davidjperez00/alarm-system/hardware/alarm_system_hardware/manufacturing/V0.02/bom-JLCPCB Assembly Order.xls

JLCPCB BOM Tool - BOM Matching
BOM name：bom-JLCPCB Assembly Order.xlsx |  |  | Download Time：2026-09-25 21:37:16 |  |  |  | * Our matching results are updated in real-time, but stock and prices may change. If it's been over 24 hours, please re-match before placing your order.
PCB Assembled Qty：5 |  |  | Est. Total Price：55.9497
Your BOM |  |  |  | Matched Parts |  |  |  |  |  |  | Order Information
Designator | Comment | Footprint | JLCPCB Part # | Matches | Part # | Manufacturer | Footprint | Description | Category | Warning | JLCPCB Part # | Product link | Lib Type | Qty | Source | Total Price ($)
BZ1 | Buzzer | PS1440P02BT_TDK |  | Select by Customer | PS1440P02BT | TDK | 插件,D=14mm | -10℃~+70℃ 14mm 30V 3V 4kHz 5mm 75dB 9.2mm Passive (Externally Driven) Piezoelectric Through-hole 插件,D=14mm Buzzers ROHS | Buzzers |  | C96060 | https://jlcpcb.com/partdetail/TDK-PS1440P02BT/C96060 | Extended | 2 | 2 JLCPCB | 0.8342
C1,C16,C17,C18,C22,C6,C8 | 0.1uF | 0805 |  | Unconfirmed | CC0805KRX7R9BB104 | YAGEO | 0805 | 100nF 50V X7R ±10% 0805 Multilayer Ceramic Capacitors MLCC - SMD/SMT ROHS | Multilayer Ceramic Capacitors MLCC - SMD/SMT | 1.The comment (CC0805KRX7R9BB104) of this part does not match the one (0.1uF) provided in your BOM. Please confirm; | C49678 | https://jlcpcb.com/partdetail/YAGEO-CC0805KRX7R9BB104/C49678 | Basic | 24 | 24 JLCPCB | 0.4584
C10,C2,C23,C3,C4,C5 | 1uF | 0805 |  | Select by System | CL21B105KBFNNNE | Samsung Electro-Mechanics | 0805 | 1uF 50V X7R ±10% 0805 Multilayer Ceramic Capacitors MLCC - SMD/SMT ROHS | Multilayer Ceramic Capacitors MLCC - SMD/SMT |  | C28323 | https://jlcpcb.com/partdetail/29074-CL21B105KBFNNNE/C28323 | Basic | 22 | 22 JLCPCB | 0.8756
C11,C12,C15,C24,C7,C9 | 10uF | 0805 |  | Select by System | CL21A106KAYNNNE | Samsung Electro-Mechanics | 0805 | 10uF 25V X5R ±10% 0805 Multilayer Ceramic Capacitors MLCC - SMD/SMT ROHS | Multilayer Ceramic Capacitors MLCC - SMD/SMT |  | C15850 | https://jlcpcb.com/partdetail/16532-CL21A106KAYNNNE/C15850 | Basic | 22 | 22 JLCPCB | 1.7336
C13 | 47nF | 0805 |  | Select by System | CL21B473KBCNNNC | Samsung Electro-Mechanics | 0805 | 47nF 50V X7R ±10% 0805 Multilayer Ceramic Capacitors MLCC - SMD/SMT ROHS | Multilayer Ceramic Capacitors MLCC - SMD/SMT |  | C53134 | https://jlcpcb.com/partdetail/54150-CL21B473KBCNNNC/C53134 | Basic | 20 | 20 JLCPCB | 0.346
C14 | 4.7uF | 0805 |  | Select by System | CL21A475KAQNNNE | Samsung Electro-Mechanics | 0805 | 25V 4.7uF X5R ±10% 0805 Multilayer Ceramic Capacitors MLCC - SMD/SMT ROHS | Multilayer Ceramic Capacitors MLCC - SMD/SMT |  | C1779 | https://jlcpcb.com/partdetail/2131-CL21A475KAQNNNE/C1779 | Basic | 20 | 20 JLCPCB | 0.69
C19,C21 | 22uF | 0805 |  | Select by System | CL21A226MAQNNNE | Samsung Electro-Mechanics | 0805 | 22uF 25V X5R ±20% 0805 Multilayer Ceramic Capacitors MLCC - SMD/SMT ROHS | Multilayer Ceramic Capacitors MLCC - SMD/SMT |  | C45783 | https://jlcpcb.com/partdetail/46786-CL21A226MAQNNNE/C45783 | Basic | 4 | 4 JLCPCB | 0.8796
D1,D11,D15,D2,D3,D4,D5,D6,D7,D8 | GREENLED | 0805 |  | Unconfirmed | KT-0805G | Hubei KENTO Elec | 0805 | -40℃~+85℃ 100mW 120° 2.6V~3.1V 430mcd 513nm~528nm 525nm 5mA Discrete Diode Emerald Green Water Clear 0805 LED Indication - Discrete ROHS | LED Indication - Discrete | 1.The comment (KT-0805G) of this part does not match the one (GREENLED) provided in your BOM. Please confirm; | C2297 | https://jlcpcb.com/partdetail/Hubei_KENTOElec-KT0805G/C2297 | Basic | 30 | 30 JLCPCB | 0.489
D9 | TSD05DYFR | D_SOD-323_HandSoldering |  | Select by System | TSD05DYFR | Texas Instruments | SOD-323 | -55℃~+150℃ 15V 19pF 5.5V 50nA 529W@8/20us 60A@8/20us 6V IEC 61000-4-2、IEC 61000-4-5 TVS SOD-323 ESD and Surge Protection (TVS/ESD) ROHS | ESD And Surge Protection (TVS/ESD) |  | C22396185 | https://jlcpcb.com/partdetail/TexasInstruments-TSD05DYFR/C22396185 | Extended | 6 | 6 JLCPCB | 1.4022
D10,D12,D13 | REDLED | 0805 |  | Select by Customer | LTST-C171KRKT | Lite-On | 0805 | -55℃~+85℃ 130° 20mA 2V 54mcd 631nm 639nm 75mW Discrete Diode Red Water Clear 0805 LED Indication - Discrete ROHS | LED Indication - Discrete |  | C284871 | https://jlcpcb.com/partdetail/LiteOn-LTSTC171KRKT/C284871 | Extended | 20 | 20 JLCPCB | 0.524
F1 | Fuse | 0805 |  | Select by Customer | MFU0805FF03000P500 | Vishay Intertech | 0805 | -55℃~+125℃ 0.023 0.45mm 1.25mm 2mm 32V 3A 50A Surface Mount Fuse 0805 Disposable fuses ROHS | Disposable Fuses |  | C3162437 | https://jlcpcb.com/partdetail/VishayIntertech-MFU0805FF03000P500/C3162437 | Extended | 2 | 2 JLCPCB | 1.0816
FB1 | BBUP00321611121Y00 | 1206 |  | Select by System | BBUP00321611121Y00 | Chilisin Elec | 1206 | -55℃~+125℃ 1 120Ω@100MHz 12mΩ 6A ±25% 1206 Ferrite Beads ROHS | Ferrite Beads |  | C6751041 | https://jlcpcb.com/partdetail/ChilisinElec-BBUP00321611121Y00/C6751041 | Extended | 15 | 15 JLCPCB | 1.0365
IC1 | PCA9955BTWJ | SOP65P640X110-29N |  | Select by System | PCA9955BTWJ | NXP Semicon | HTSSOP-28-EP | -40℃~+105℃ 16 31.25kHz~1MHz 3V~5.5V 4% 57mA DC-DC Over-Temperature Protection (OTP)、Short-Circuit Protection PWM、I2C HTSSOP-28-EP LED Drivers ROHS | LED Drivers |  | C2678563 | https://jlcpcb.com/partdetail/NXPSemicon-PCA9955BTWJ/C2678563 | Extended | 2 | 2 JLCPCB | 5.7846
J2 | USB_C_Receptacle_USB2.0_16P | SAMESKY_UJ20-C-H-G-SMT-1-P16-TR |  | Select by Customer | UJ20-C-H-G-SMT-1-P16-TR | CUI | SMD | -25℃~+85℃ 1 10,000 cycles 16P 20V 5A Female Surface Mount, Right Angle Type-C USB 2.0 SMD USB Connectors ROHS |  |  | C45082766 | https://jlcpcb.com/partdetail/CUI-UJ20_C_H_G_SMT_1_P16TR/C45082766 | Extended | 2 | 2 JLCPCB | 1.5006
J4 | Conn_01x02_Socket | CONN_S2B-PH-K-S_JST |  | Select by Customer | S2B-PH-K-S-GW | JST | 弯插,P=2mm | -25℃~+85℃ 1 100V 1x2P 2 2A 2P 2mm 4.8mm 5.9mm 7.6mm Brass K Pin PA66 PH Right Angle Tin UL94V-0 White 弯插,P=2mm Wire To Board Connector ROHS | Wire To Board Connector |  | C157932 | https://jlcpcb.com/partdetail/JST-S2B_PH_K_SGW/C157932 | Extended | 2 | 2 JLCPCB | 0.4406
J5 | MSD-11-A | CUI_MSD-11-A |  | Select by System | MSD-11-A | CUI | SMD | -40℃~+85℃ 1.85mm 30V Connector and Ejector MicroSD Card (TF Card) Push-Pull With Locating Pins SMD SD Card / Memory Card Connector ROHS | Global Sourcing Parts |  | C22467016 | https://jlcpcb.com/partdetail/CUI-MSD_11A/C22467016 | Extended | 2 | 2 JLCPCB | 1.741
J7 | Conn_01x03_Socket | TerminalBlock_Phoenix_PT-1,5-3-5.0-H_1x03_P5.00mm_Horizontal |  | Select by Customer | 1935174 | Phoenix Contact | 插件,P=5mm | 1 12~26 18A 1x3P 3 300V 3P 5mm Green Through Hole 插件,P=5mm Screw Terminal Blocks ROHS | Screw Terminal Blocks |  | C3816891 | https://jlcpcb.com/partdetail/PhoenixContact-1935174/C3816891 | Extended | 2 | 2 JLCPCB | 1.9716
L1 | 1uH | IND_VLS5045EX-1R0N |  | Select by Customer | VLS5045EX-1R0N | TDK | SMD,5x5mm | 15mΩ 1uH 5.1A 8.9A ±30% SMD,5x5mm Power Inductors ROHS | Power Inductors |  | C404484 | https://jlcpcb.com/partdetail/TDK-VLS5045EX1R0N/C404484 | Extended | 5 | 5 JLCPCB | 0.6775
L2 | 0.47uH | IND_IHLP-2020CZ-L |  | Select by Customer | FAUL0530-R47MT | cjiang (Changjiang Microelectronics Tech) | SMD,5.4x5.2mm | 11A 15A 470nH 8.5mΩ ±20% SMD,5.4x5.2mm Molding Power Inductors ROHS | Power Inductors | 1.The comment (FAUL0530-R47MT) of this part does not match the one (0.47uH) provided in your BOM. Please confirm; | C5298158 | https://jlcpcb.com/partdetail/6046328-FAUL0530R47MT/C5298158 | Extended | 5 | 5 JLCPCB | 1.5355
Q1 | AO3400A | SOT-23-3 |  | Select by System | AO3400A | Alpha & Omega Semicon | SOT-23 | -55℃~+150℃ 1 N-channel 1.45V 1.4W 30V 48mΩ@2.5V 5.7A 50pF 630pF 75pF 7nC@10V N-Channel SOT-23 MOSFETs ROHS | MOSFETs |  | C20917 | https://jlcpcb.com/partdetail/Alpha_OmegaSemicon-AO3400A/C20917 | Basic | 6 | 6 JLCPCB | 0.507
R1,R18,R19,R2,R24,R3,R30 | 10k | 0805 |  | Unconfirmed | 0805W8F1002T5E | UNI-ROYAL(Uniroyal Elec) | 0805 | -55℃~+155℃ 10kΩ 125mW 150V Thick Film Resistor ±1% ±100ppm/℃ 0805 Chip Resistor - Surface Mount ROHS | Chip Resistor - Surface Mount | 1.The comment (0805W8F1002T5E) of this part does not match the one (10k) provided in your BOM. Please confirm; | C17414 | https://jlcpcb.com/partdetail/18102-0805W8F1002T5E/C17414 | Basic | 24 | 24 JLCPCB | 0.0936
R10,R13,R53,R7,R8,R9 | 330 | 0805 |  | Unconfirmed | 0805W8F3300T5E | UNI-ROYAL(Uniroyal Elec) | 0805 | -55℃~+155℃ 125mW 150V 330Ω Thick Film Resistor ±1% ±100ppm/℃ 0805 Chip Resistor - Surface Mount ROHS | Chip Resistor - Surface Mount | 1.The comment (0805W8F3300T5E) of this part does not match the one (330) provided in your BOM. Please confirm; | C17630 | https://jlcpcb.com/partdetail/18318-0805W8F3300T5E/C17630 | Basic | 22 | 22 JLCPCB | 0.1078
R11 | 47k | 0805 |  | Unconfirmed | 0805W8F4702T5E | UNI-ROYAL(Uniroyal Elec) | 0805 | -55℃~+155℃ 125mW 150V 47kΩ Thick Film Resistor ±1% ±100ppm/℃ 0805 Chip Resistor - Surface Mount ROHS | Chip Resistor - Surface Mount | 1.The comment (0805W8F4702T5E) of this part does not match the one (47k) provided in your BOM. Please confirm; | C17713 | https://jlcpcb.com/partdetail/18401-0805W8F4702T5E/C17713 | Basic | 20 | 20 JLCPCB | 0.134
R12,R4,R5,R6 | 8.25k | 0805 |  | Unconfirmed | 1RC0805F8251 | SAE | 0805 | 0805 Chip Resistor - Surface Mount ROHS |  | 1.The comment (1RC0805F8251) of this part does not match the one (8.25k) provided in your BOM. Please confirm; | C54532369 | https://jlcpcb.com/partdetail/SAE-1RC0805F8251/C54532369 | Extended | 20 | 20 JLCPCB | 0.07
R14,R15,R27,R28,R29,R32,R54 | 100k | 0805 |  | Unconfirmed | 0805W8F1003T5E | UNI-ROYAL(Uniroyal Elec) | 0805 | -55℃~+155℃ 100kΩ 125mW 150V Thick Film Resistor ±1% ±100ppm/℃ 0805 Chip Resistor - Surface Mount ROHS | Chip Resistor - Surface Mount | 1.The comment (0805W8F1003T5E) of this part does not match the one (100k) provided in your BOM. Please confirm; | C149504 | https://jlcpcb.com/partdetail/160838-0805W8F1003T5E/C149504 | Basic | 24 | 24 JLCPCB | 0.1416
R16,R17,R35,R39,R43,R51,R52 | 0 | 0805 |  | Unconfirmed | 0805W8F0000T5E | UNI-ROYAL(Uniroyal Elec) | 0805 | -55℃~+155℃ 0Ω 125mW 150V Thick Film Resistor ±1% ±800ppm/℃ 0805 Chip Resistor - Surface Mount ROHS | Chip Resistor - Surface Mount | 1.The comment (0805W8F0000T5E) of this part does not match the one (0) provided in your BOM. Please confirm; | C17477 | https://jlcpcb.com/partdetail/18165-0805W8F0000T5E/C17477 | Basic | 24 | 24 JLCPCB | 0.1056
R20 | 2k | 0805 |  | Unconfirmed | 0805W8F2001T5E | UNI-ROYAL(Uniroyal Elec) | 0805 | -55℃~+155℃ 125mW 150V 2kΩ Thick Film Resistor ±1% ±100ppm/℃ 0805 Chip Resistor - Surface Mount ROHS | Chip Resistor - Surface Mount | 1.The comment (0805W8F2001T5E) of this part does not match the one (2k) provided in your BOM. Please confirm; | C17604 | https://jlcpcb.com/partdetail/18292-0805W8F2001T5E/C17604 | Basic | 20 | 20 JLCPCB | 0.078
R21,R23 | 4.7k | 0805 |  | Unconfirmed | 0805W8F4701T5E | UNI-ROYAL(Uniroyal Elec) | 0805 | -55℃~+155℃ 125mW 150V 4.7kΩ Thick Film Resistor ±1% ±100ppm/℃ 0805 Chip Resistor - Surface Mount ROHS | Chip Resistor - Surface Mount | 1.The comment (0805W8F4701T5E) of this part does not match the one (4.7k) provided in your BOM. Please confirm; | C17673 | https://jlcpcb.com/partdetail/18361-0805W8F4701T5E/C17673 | Basic | 20 | 20 JLCPCB | 0.1
R25 | 909k | 0805 |  | Unconfirmed | 1RC0805F9093 | SAE | 0805 | 0805 Chip Resistor - Surface Mount ROHS |  | 1.The comment (1RC0805F9093) of this part does not match the one (909k) provided in your BOM. Please confirm; | C54532387 | https://jlcpcb.com/partdetail/SAE-1RC0805F9093/C54532387 | Extended | 20 | 20 JLCPCB | 0.066
R31,R33,R45 | 200 | 0805 |  | Unconfirmed | 0805W8F2000T5E | UNI-ROYAL(Uniroyal Elec) | 0805 | -55℃~+155℃ 125mW 150V 200Ω Thick Film Resistor ±1% ±100ppm/℃ 0805 Chip Resistor - Surface Mount ROHS | Chip Resistor - Surface Mount | 1.The comment (0805W8F2000T5E) of this part does not match the one (200) provided in your BOM. Please confirm; | C17540 | https://jlcpcb.com/partdetail/18228-0805W8F2000T5E/C17540 | Basic | 20 | 20 JLCPCB | 0.134
R36 | 432 | 0805 |  | Unconfirmed | 0805W8F4301T5E | UNI-ROYAL(Uniroyal Elec) | 0805 | -55℃~+155℃ 125mW 150V 4.3kΩ Thick Film Resistor ±1% ±100ppm/℃ 0805 Chip Resistor - Surface Mount ROHS | Chip Resistor - Surface Mount | 1.The comment (0805W8F4301T5E) of this part does not match the one (432) provided in your BOM. Please confirm; | C17667 | https://jlcpcb.com/partdetail/18355-0805W8F4301T5E/C17667 | Extended | 20 | 20 JLCPCB | 0.158
R37 | 5.36k | 0805 |  | Unconfirmed | FRC0805F5361TS | FOJAN | 0805 | -55℃~+155℃ 125mW 150V 5.36kΩ Thick Film Resistor ±1% ±100ppm/℃ 0805 Chip Resistor - Surface Mount ROHS | Chip Resistor - Surface Mount | 1.The comment (FRC0805F5361TS) of this part does not match the one (5.36k) provided in your BOM. Please confirm; | C2999602 | https://jlcpcb.com/partdetail/FOJAN-FRC0805F5361TS/C2999602 | Extended | 20 | 20 JLCPCB | 0.064
R38 | 31.6k | 0805 |  | Unconfirmed | 0805W8F3162T5E | UNI-ROYAL(Uniroyal Elec) | 0805 | -55℃~+155℃ 125mW 150V 31.6kΩ Thick Film Resistor ±1% ±100ppm/℃ 0805 Chip Resistor - Surface Mount ROHS | Chip Resistor - Surface Mount | 1.The comment (0805W8F3162T5E) of this part does not match the one (31.6k) provided in your BOM. Please confirm; | C17623 | https://jlcpcb.com/partdetail/18311-0805W8F3162T5E/C17623 | Extended | 20 | 20 JLCPCB | 0.078
R41 | 511k | 0805 |  | Unconfirmed | FRC0805F5113TS | FOJAN | 0805 | -55℃~+155℃ 125mW 150V 511kΩ Thick Film Resistor ±1% ±100ppm/℃ 0805 Chip Resistor - Surface Mount ROHS | Chip Resistor - Surface Mount | 1.The comment (FRC0805F5113TS) of this part does not match the one (511k) provided in your BOM. Please confirm; | C5159719 | https://jlcpcb.com/partdetail/FOJAN-FRC0805F5113TS/C5159719 | Extended | 20 | 20 JLCPCB | 0.066
R42 | 91k | 0805 |  | Unconfirmed | FRC0805F9102TS | FOJAN | 0805 | -55℃~+155℃ 125mW 150V 91kΩ Thick Film Resistor ±1% ±100ppm/℃ 0805 Chip Resistor - Surface Mount ROHS | Chip Resistor - Surface Mount | 1.The comment (FRC0805F9102TS) of this part does not match the one (91k) provided in your BOM. Please confirm; | C2933509 | https://jlcpcb.com/partdetail/FOJAN-FRC0805F9102TS/C2933509 | Extended | 20 | 20 JLCPCB | 0.074
R44 | 1050 | 0805 |  | Unconfirmed | FRC0805F1051TS | FOJAN | 0805 | -55℃~+155℃ 1.05kΩ 125mW 150V Thick Film Resistor ±1% ±100ppm/℃ 0805 Chip Resistor - Surface Mount ROHS | Chip Resistor - Surface Mount | 1.The comment (FRC0805F1051TS) of this part does not match the one (1050) provided in your BOM. Please confirm; | C2933283 | https://jlcpcb.com/partdetail/FOJAN-FRC0805F1051TS/C2933283 | Extended | 20 | 20 JLCPCB | 0.068
R46 | 499 | 0805 |  | Unconfirmed | FRC0805F4990TS | FOJAN | 0805 | -55℃~+155℃ 125mW 150V 499Ω Thick Film Resistor ±1% ±100ppm/℃ 0805 Chip Resistor - Surface Mount ROHS | Chip Resistor - Surface Mount | 1.The comment (FRC0805F4990TS) of this part does not match the one (499) provided in your BOM. Please confirm; | C2933453 | https://jlcpcb.com/partdetail/FOJAN-FRC0805F4990TS/C2933453 | Extended | 20 | 20 JLCPCB | 0.074
R47,R48 | 10M | 0805 |  | Unconfirmed | 1RC0805J0106 | SAE | 0805 | 0805 Chip Resistor - Surface Mount ROHS |  | 1.The comment (1RC0805J0106) of this part does not match the one (10M) provided in your BOM. Please confirm; | C54531803 | https://jlcpcb.com/partdetail/SAE-1RC0805J0106/C54531803 | Extended | 20 | 20 JLCPCB | 0.06
R49,R50 | 200k | 0805 |  | Unconfirmed | 0805W8F2003T5E | UNI-ROYAL(Uniroyal Elec) | 0805 | -55℃~+155℃ 125mW 150V 200kΩ Thick Film Resistor ±1% ±100ppm/℃ 0805 Chip Resistor - Surface Mount ROHS | Chip Resistor - Surface Mount | 1.The comment (0805W8F2003T5E) of this part does not match the one (200k) provided in your BOM. Please confirm; | C17539 | https://jlcpcb.com/partdetail/18227-0805W8F2003T5E/C17539 | Basic | 20 | 20 JLCPCB | 0.112
SW1,SW2,SW3,SW5,SW7,SW8 | SW_SPST | SW_SPST_CK_RS282G05A3 |  | Select by Customer | PTS636 SK25F SMTR LFS | C&K | 插件 | -40℃~+90℃ 12V 2.5N 50mA IP40 Rectangular Button SMD(SMT) Tab SPST-NO Surface Mount,Vertical 插件 Tactile Switches ROHS | Tactile Switches |  | C2800760 | https://jlcpcb.com/partdetail/CK-PTS636_SK25F_SMTRLFS/C2800760 | Extended | 12 | 12 JLCPCB | 3.5184
SW4 | SW_Reed_Opener | TerminalBlock_Phoenix_PT-1,5-2-5.0-H_1x02_P5.00mm_Horizontal |  | Select by Customer | 1935161 | Phoenix Contact | 插件,P=5mm | 1 12~26 18A 1x2P 2 2P 300V 5mm Green Through Hole 插件,P=5mm Screw Terminal Blocks ROHS | Screw Terminal Blocks |  | C3819953 | https://jlcpcb.com/partdetail/PhoenixContact-1935161/C3819953 | Extended | 2 | 2 JLCPCB | 1.3414
U1 | TPS63802DLAR | DLA0010A |  | Select by System | TPS63802DLAR | Texas Instruments | VSON-10(2x3) | -40℃~+125℃@(TJ) 1 1.3V~5.5V 1.4MHz、1.6MHz、2.1MHz 1.8V~5.2V 11uA 2A Adjustable Buck-Boost Buck-Boost Built-in Yes VSON-10(2x3) DC-DC Converters ROHS | DC-DC Converters |  | C2845237 | https://jlcpcb.com/partdetail/TexasInstruments-TPS63802DLAR/C2845237 | Extended | 2 | 2 JLCPCB | 2.03
U2 | ESP32-S3-WROOM-1-N8R8 | ESP32-S3-WROOM-1 |  | Select by System | ESP32-S3-WROOM-1-N8R8 | Espressif Systems | SMD,25.5x18mm | -104.5dBm -40℃~+65℃ 2.4GHz 20.5dBm 330mA 3V~3.6V 97mA Bluetooth5.0 ESP32-S3R8 On-board PCB Antenna UART、SPI、I2C、GPIO、I2S、USB SMD,25.5x18mm WiFi Modules ROHS | WiFi Modules |  | C2913201 | https://jlcpcb.com/partdetail/3198299-ESP32_S3_WROOM_1N8R8/C2913201 | Extended | 2 | 2 JLCPCB | 9.997
U3 | MAX98357A | TQFN-16-1EP_3x3mm_P0.5mm_EP1.23x1.23mm |  | Unconfirmed | MAX98357AETE+T | Analog Devices Inc./Maxim Integrated | TQFN-16-EP(3x3) | -40℃~+85℃ 2.4mA 2.5V~5.5V 3.2Wx1@4Ω 77dB 92% Automatic mute/no-noise switch、Enable/shutdown function、Filterless architecture Class D TQFN-16-EP(3x3) Audio Amplifiers ROHS | Audio Amplifiers | 1.The comment (MAX98357AETE+T) of this part does not match the one (MAX98357A) provided in your BOM. Please confirm; | C910544 | https://jlcpcb.com/partdetail/978950-MAX98357AETET/C910544 | Extended | 2 | 2 JLCPCB | 2.6276
U4 | BQ25616JRTWR | WQFN24_RTW_TEX |  | Select by Customer | BQ25616RTWR | Texas Instruments | QFN-24-EP(4x4) | -40℃~+85℃ 1 3A 4.2V 4V~13.5V 9.5uA Charging IC Lithium Battery Support QFN-24-EP(4x4) Battery Management ROHS | Battery Management |  | C2866447 | https://jlcpcb.com/partdetail/TexasInstruments-BQ25616RTWR/C2866447 | Extended | 2 | 2 JLCPCB | 4.3002
U5 | PESD4USB5BTBS-QX | Diodes_UDFN-10_1.0x2.5mm_P0.5mm |  | Select by Customer | TPESD4USB5BTBS-QX | TECH PUBLIC | DFN2510-10 | DFN2510-10 ESD and Surge Protection (TVS/ESD) ROHS |  | 1.The comment (TPESD4USB5BTBS-QX) of this part does not match the one (PESD4USB5BTBS-QX) provided in your BOM. Please confirm; | C55114365 | https://jlcpcb.com/partdetail/TECHPUBLIC-TPESD4USB5BTBSQX/C55114365 | Extended | 5 | 5 JLCPCB | 0.602
U6 | TUSB321AIRWBR | Texas_X2QFN-12_1.6x1.6mm_P0.4mm |  | Select by System | TUSB321AIRWBR | Texas Instruments | X2-QFN-12(1.6x1.6) | -40℃~+85℃ 4.5V~5.5V 70uA USB Type-C X2-QFN-12(1.6x1.6) Interface - Specialized ROHS | Interface - Specialized |  | C2674046 | https://jlcpcb.com/partdetail/TexasInstruments-TUSB321AIRWBR/C2674046 | Extended | 2 | 2 JLCPCB | 3.0954
U10 | TMUX1204DQAR | USON10_DQA_TEX |  | Select by System | TMUX1204DQAR | Texas Instruments | USON-10(1x2.5) | -40℃~+125℃ 1.08V~5.5V 4 USON-10(1x2.5) Analog Switches, Multiplexers ROHS | Analog Switches, Multiplexers |  | C1849379 | https://jlcpcb.com/partdetail/TexasInstruments-TMUX1204DQAR/C1849379 | Extended | 5 | 5 JLCPCB | 2.144
