davidjperez00/alarm-system/hardware/alarm_system_hardware/3d_files/TMUX1204DQAR.STEP

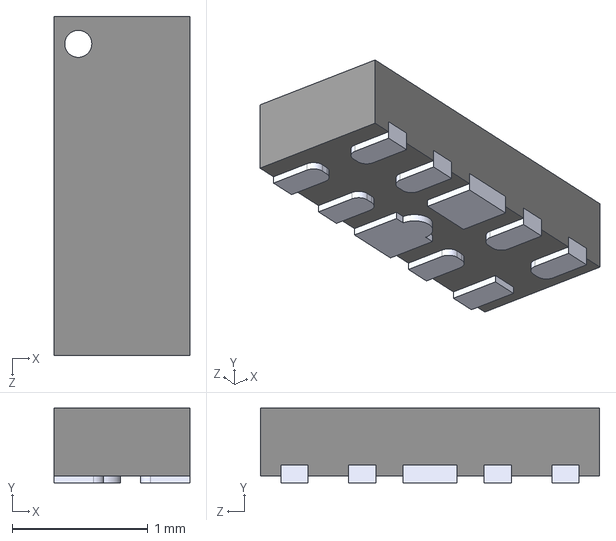
[picture p1: CAD file, 2026-08-01]
hardware/alarm_system_hardware/3d_files/TMUX1204DQAR.STEP
1.00 x 0.55 x 2.50 mm
