davidjperez00/alarm-system/hardware/alarm_system_hardware/3d_files/KS-01Q-01.STEP

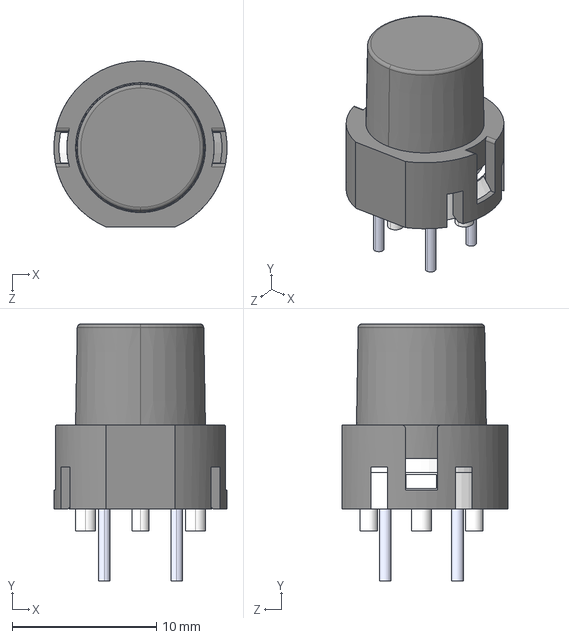
[picture p2: CAD file, 2026-08-01]
hardware/alarm_system_hardware/3d_files/KS-01Q-01.STEP
12.0 x 17.8 x 11.5 mm
