davidjperez00/alarm-system/hardware/alarm_system_hardware/3d_files/S2B-PH-K-S.STEP

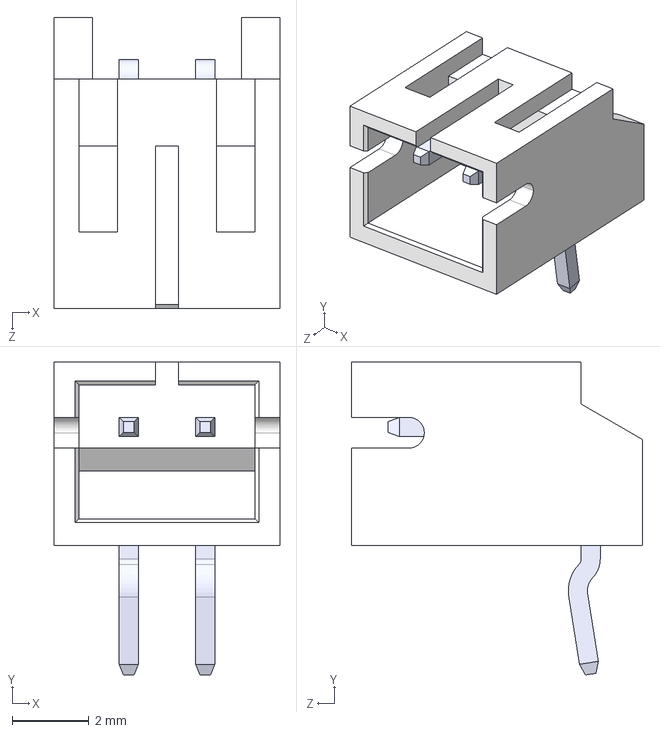
[picture p3: CAD file, 2026-08-01]
hardware/alarm_system_hardware/3d_files/S2B-PH-K-S.STEP
5.90 x 8.18 x 7.60 mm
