davidjperez00/alarm-system/hardware/alarm_system_hardware/3d_files/PS1440P02BT_TDK.step

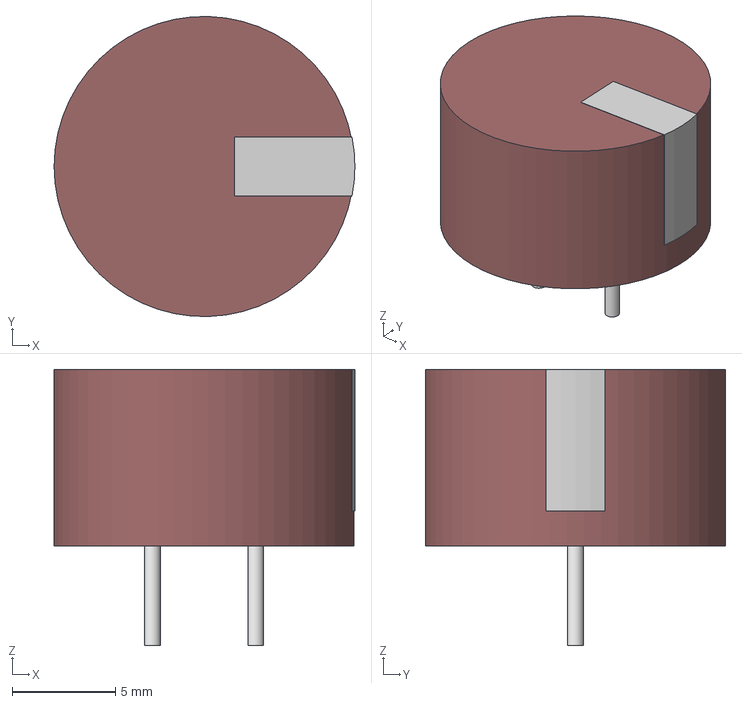
[picture p4: CAD file, 2026-08-01]
hardware/alarm_system_hardware/3d_files/PS1440P02BT_TDK.step
14.5 x 14.5 x 13.4 mm
