davidjperez00/alarm-system/hardware/alarm_system_hardware/3d_files/NCE2.stp

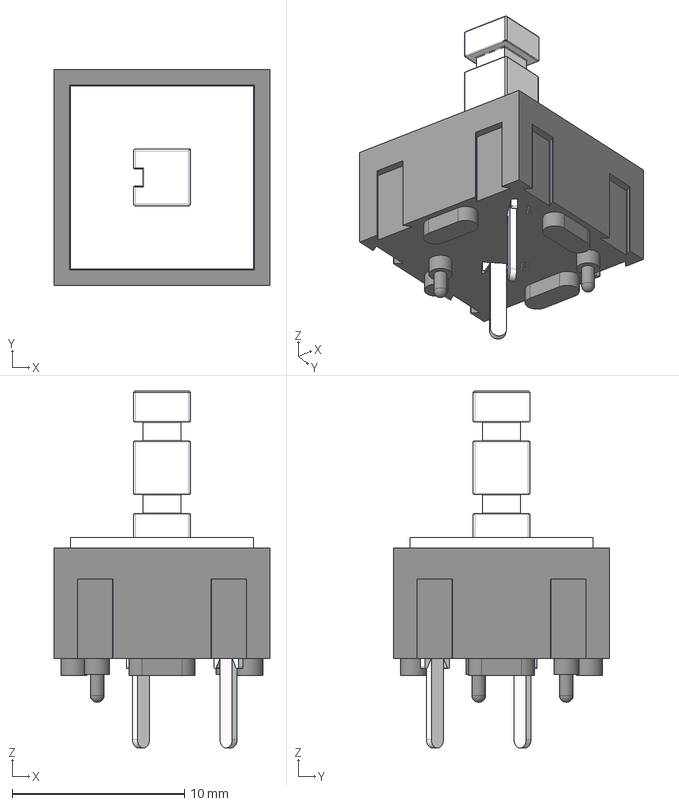
[picture p5: CAD file, 2026-08-01]
hardware/alarm_system_hardware/3d_files/NCE2.stp
12.5 x 12.5 x 20.7 mm
Terminal x 2
Actuator E
