davidjperez00/alarm-system/hardware/alarm_system_hardware/3d_files/LTST-C235KGKRKT.STEP

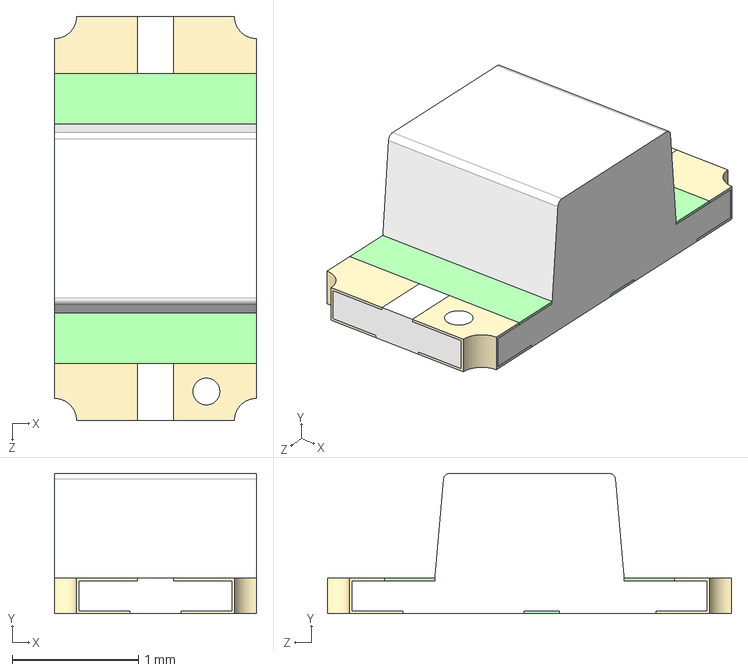
[picture p6: CAD file, 2026-08-01]
hardware/alarm_system_hardware/3d_files/LTST-C235KGKRKT.STEP
1.60 x 1.11 x 3.20 mm
