davidjperez00/alarm-system/hardware/alarm_system_hardware/3d_files/TUSB321AIRWBR.stp

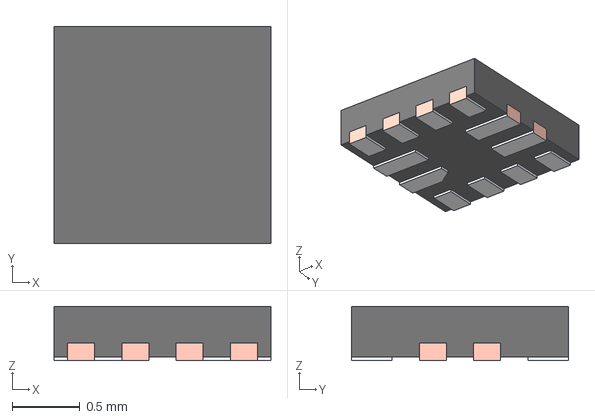
[picture p7: CAD file, 2026-08-01]
hardware/alarm_system_hardware/3d_files/TUSB321AIRWBR.stp
1.60 x 1.60 x 0.4 mm
FRAME-RWB0012A
BODY-QFN
