davidjperez00/alarm-system/hardware/alarm_system_hardware/3d_files/DQA0010A.stp

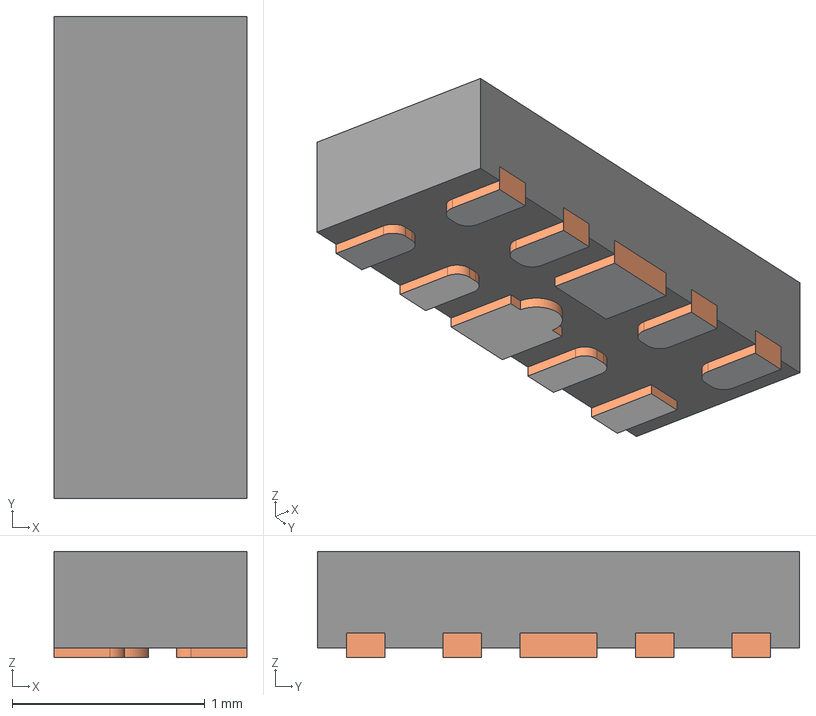
[picture p8: CAD file, 2026-05-15]
hardware/alarm_system_hardware/3d_files/DQA0010A.stp
1.00 x 2.50 x 0.55 mm
BODY-SON
FRAME-DQA0010A
PIN1-ID
