davidjperez00/alarm-system/hardware/alarm_system_hardware/3d_files/MSD-11-A.step

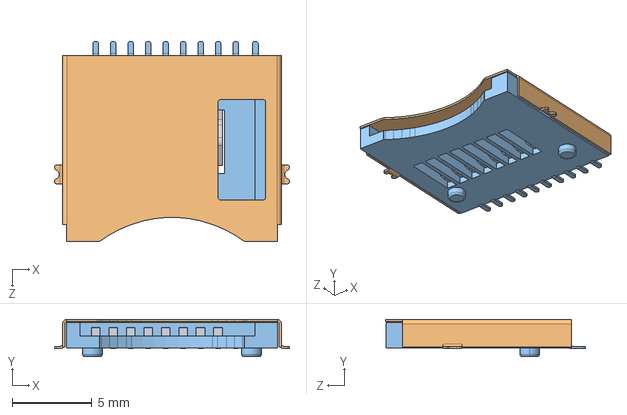
[picture p9: CAD file, 2026-05-15]
hardware/alarm_system_hardware/3d_files/MSD-11-A.step
14.8 x 2.35 x 12.6 mm
