davidjperez00/alarm-system/hardware/alarm_system_hardware/3d_files/IHLP2020CZ.step

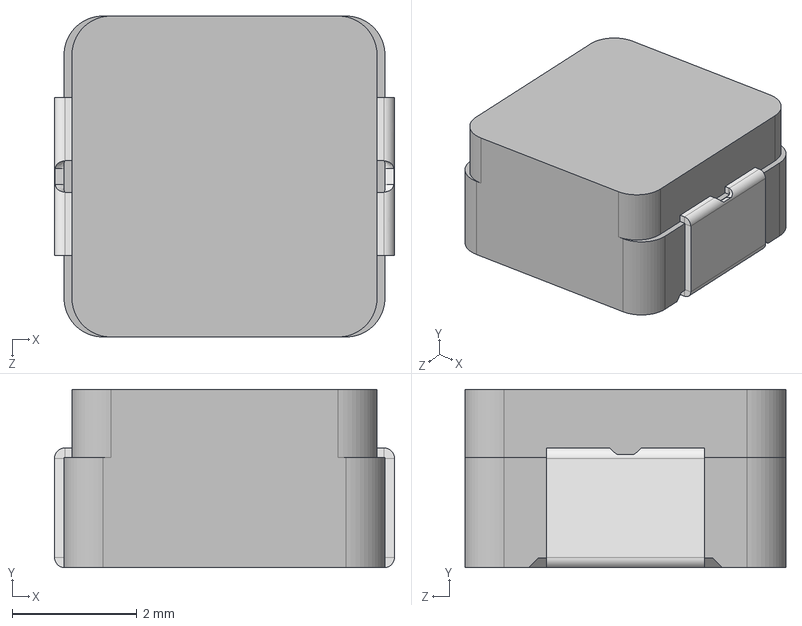
[picture p10: CAD file, 2026-05-15]
hardware/alarm_system_hardware/3d_files/IHLP2020CZ.step
5.45 x 2.86 x 5.15 mm
