davidjperez00/alarm-system/hardware/alarm_system_hardware/3d_files/VLS5045EX-1R0N.step

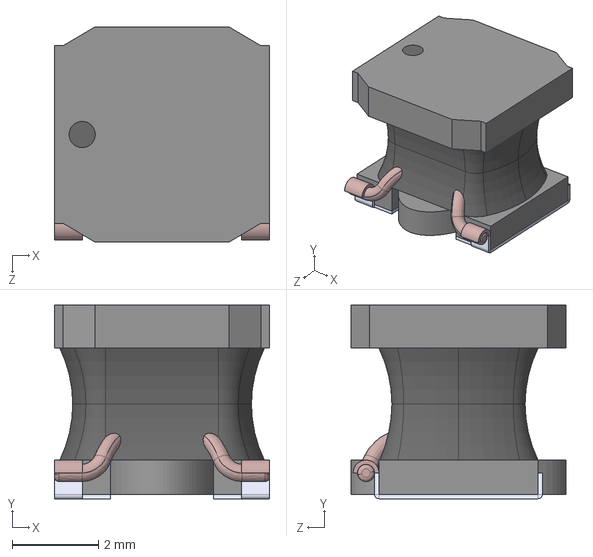
[picture p11: CAD file, 2026-05-15]
hardware/alarm_system_hardware/3d_files/VLS5045EX-1R0N.step
5.00 x 4.50 x 5.00 mm
