davidjperez00/alarm-system/hardware/alarm_system_hardware/3d_files/PCA9955BTW.stp

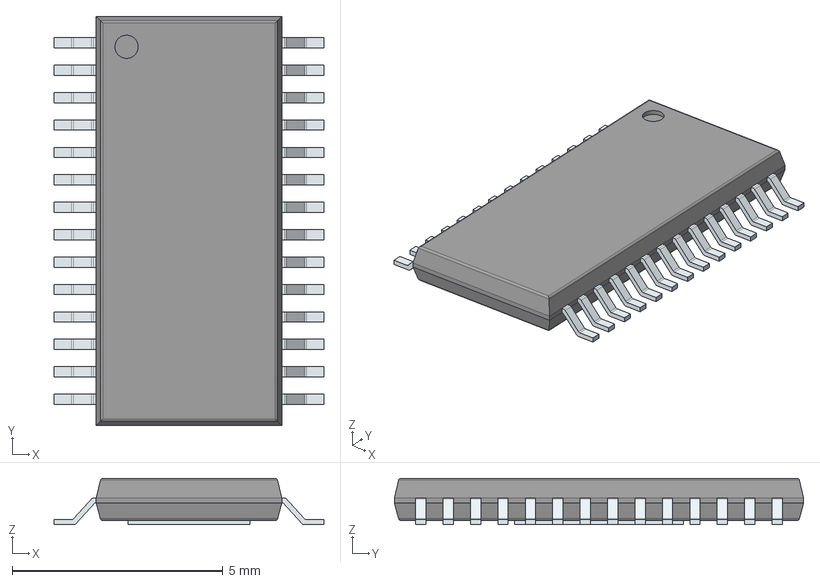
[picture p12: CAD file, 2026-05-15]
hardware/alarm_system_hardware/3d_files/PCA9955BTW.stp
6.40 x 9.70 x 1.10 mm
PinsArrayLR
ThermalPad
