davidjperez00/alarm-system/hardware/alarm_system_hardware/3d_files/UJ20-C-H-G-SMT-1-P16-TR.step

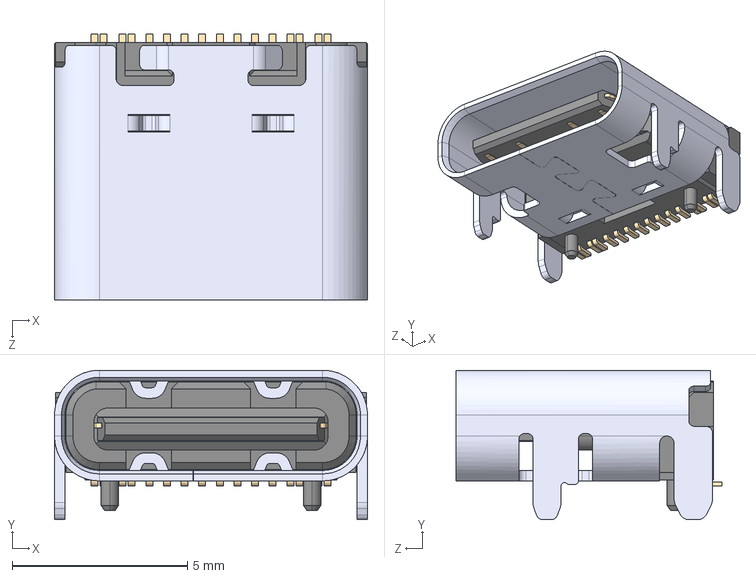
[picture p13: CAD file, 2026-05-15]
hardware/alarm_system_hardware/3d_files/UJ20-C-H-G-SMT-1-P16-TR.step
8.94 x 4.27 x 7.60 mm
