davidjperez00/alarm-system/hardware/alarm_system_hardware/3d_files/DLA0010A.stp

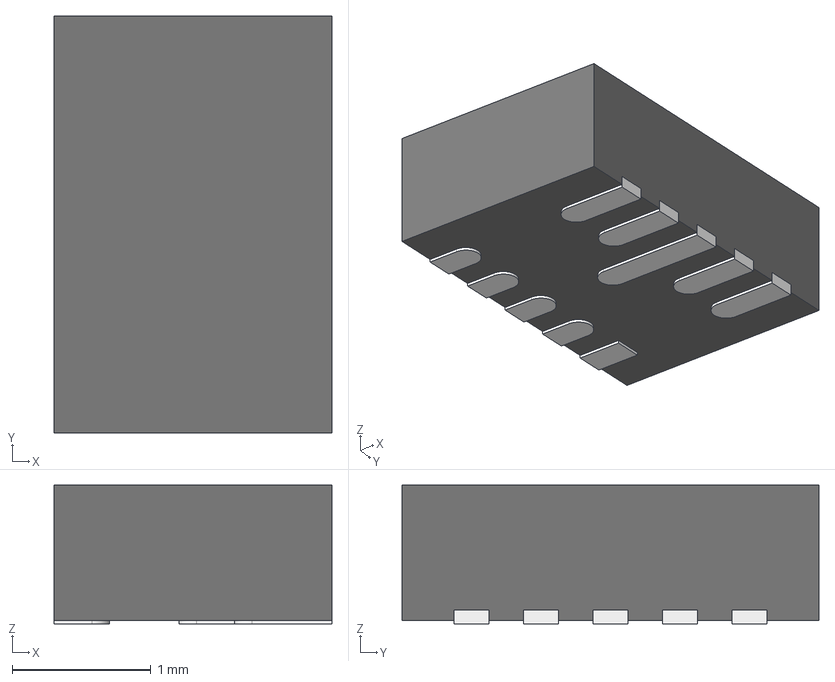
[picture p14: CAD file, 2026-05-15]
hardware/alarm_system_hardware/3d_files/DLA0010A.stp
2.00 x 3.00 x 1.00 mm
FRAME
MOLD
