davidjperez00/alarm-system/hardware/alarm_system_hardware/3d_files/RTW0024H.stp

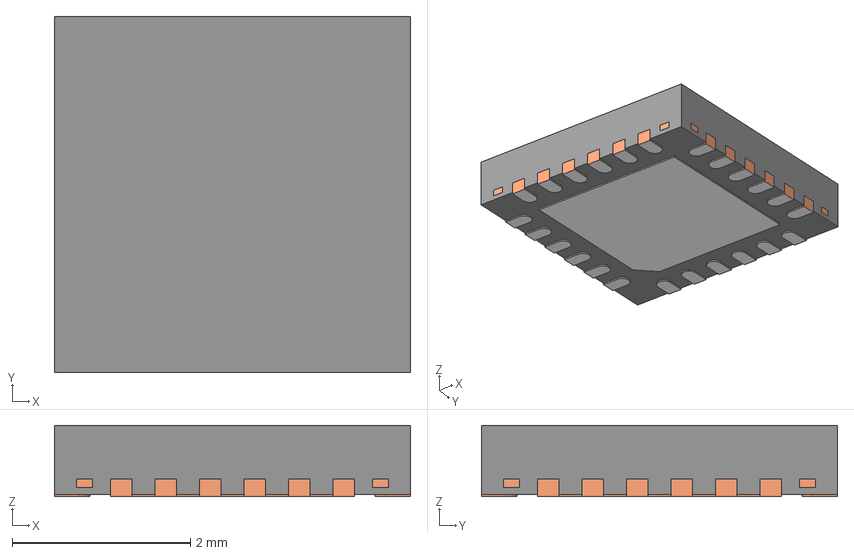
[picture p15: CAD file, 2026-05-15]
hardware/alarm_system_hardware/3d_files/RTW0024H.stp
4.00 x 4.00 x 0.8 mm
BODY-QFN
FRAME-RTW0024H
PIN1-ID
