davidjperez00/alarm-system/hardware/alarm_system_hardware/3d_files/BQ25616JRTWR.step

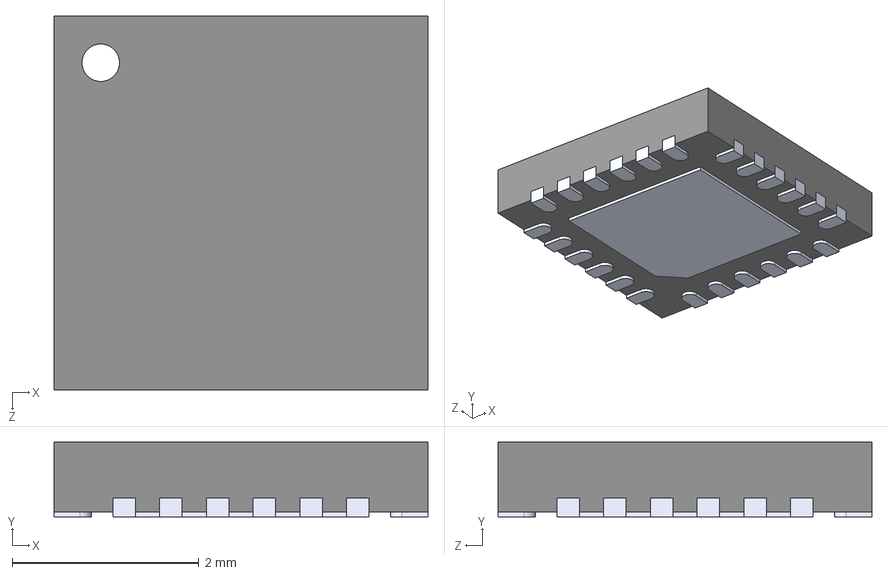
[picture p16: CAD file, 2026-08-01]
hardware/alarm_system_hardware/3d_files/BQ25616JRTWR.step
4.00 x 0.8 x 4.00 mm
