davidjperez00/alarm-system/hardware/alarm_system_hardware/3d_files/MAX98357AETE+T.STEP

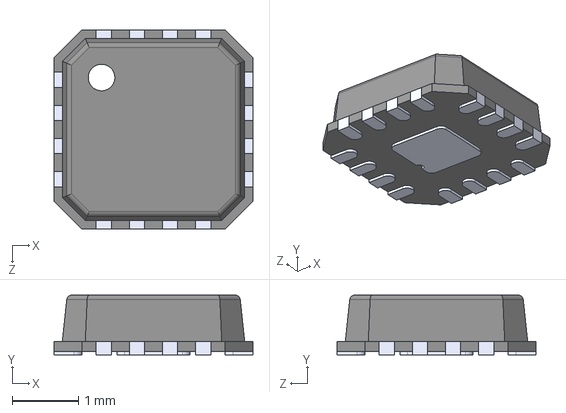
[picture p17: CAD file, 2026-08-01]
hardware/alarm_system_hardware/3d_files/MAX98357AETE+T.STEP
3.00 x 0.9 x 3.00 mm
