davidjperez00/alarm-system/(list of files, cad)

Other CAD files:
hardware/alarm_system_hardware/3d_files/TPS63802DLAR.STEP
