davidjperez00/alarm-system/CLANG_FORMAT_SETUP.md

## Clang format Setup WSL with VSCode

resource link: https://code.visualstudio.com/docs/cpp/configure-intellisense 
```
sudo apt update && sudo apt upgrade -y

```

1.
