davidjperez00/alarm-system/hardware/alarm_system_hardware/alarm_system_hardware.kicad_pcb

## KiCad design hardware/alarm_system_hardware/alarm_system_hardware.kicad_pcb (2026-10-01)

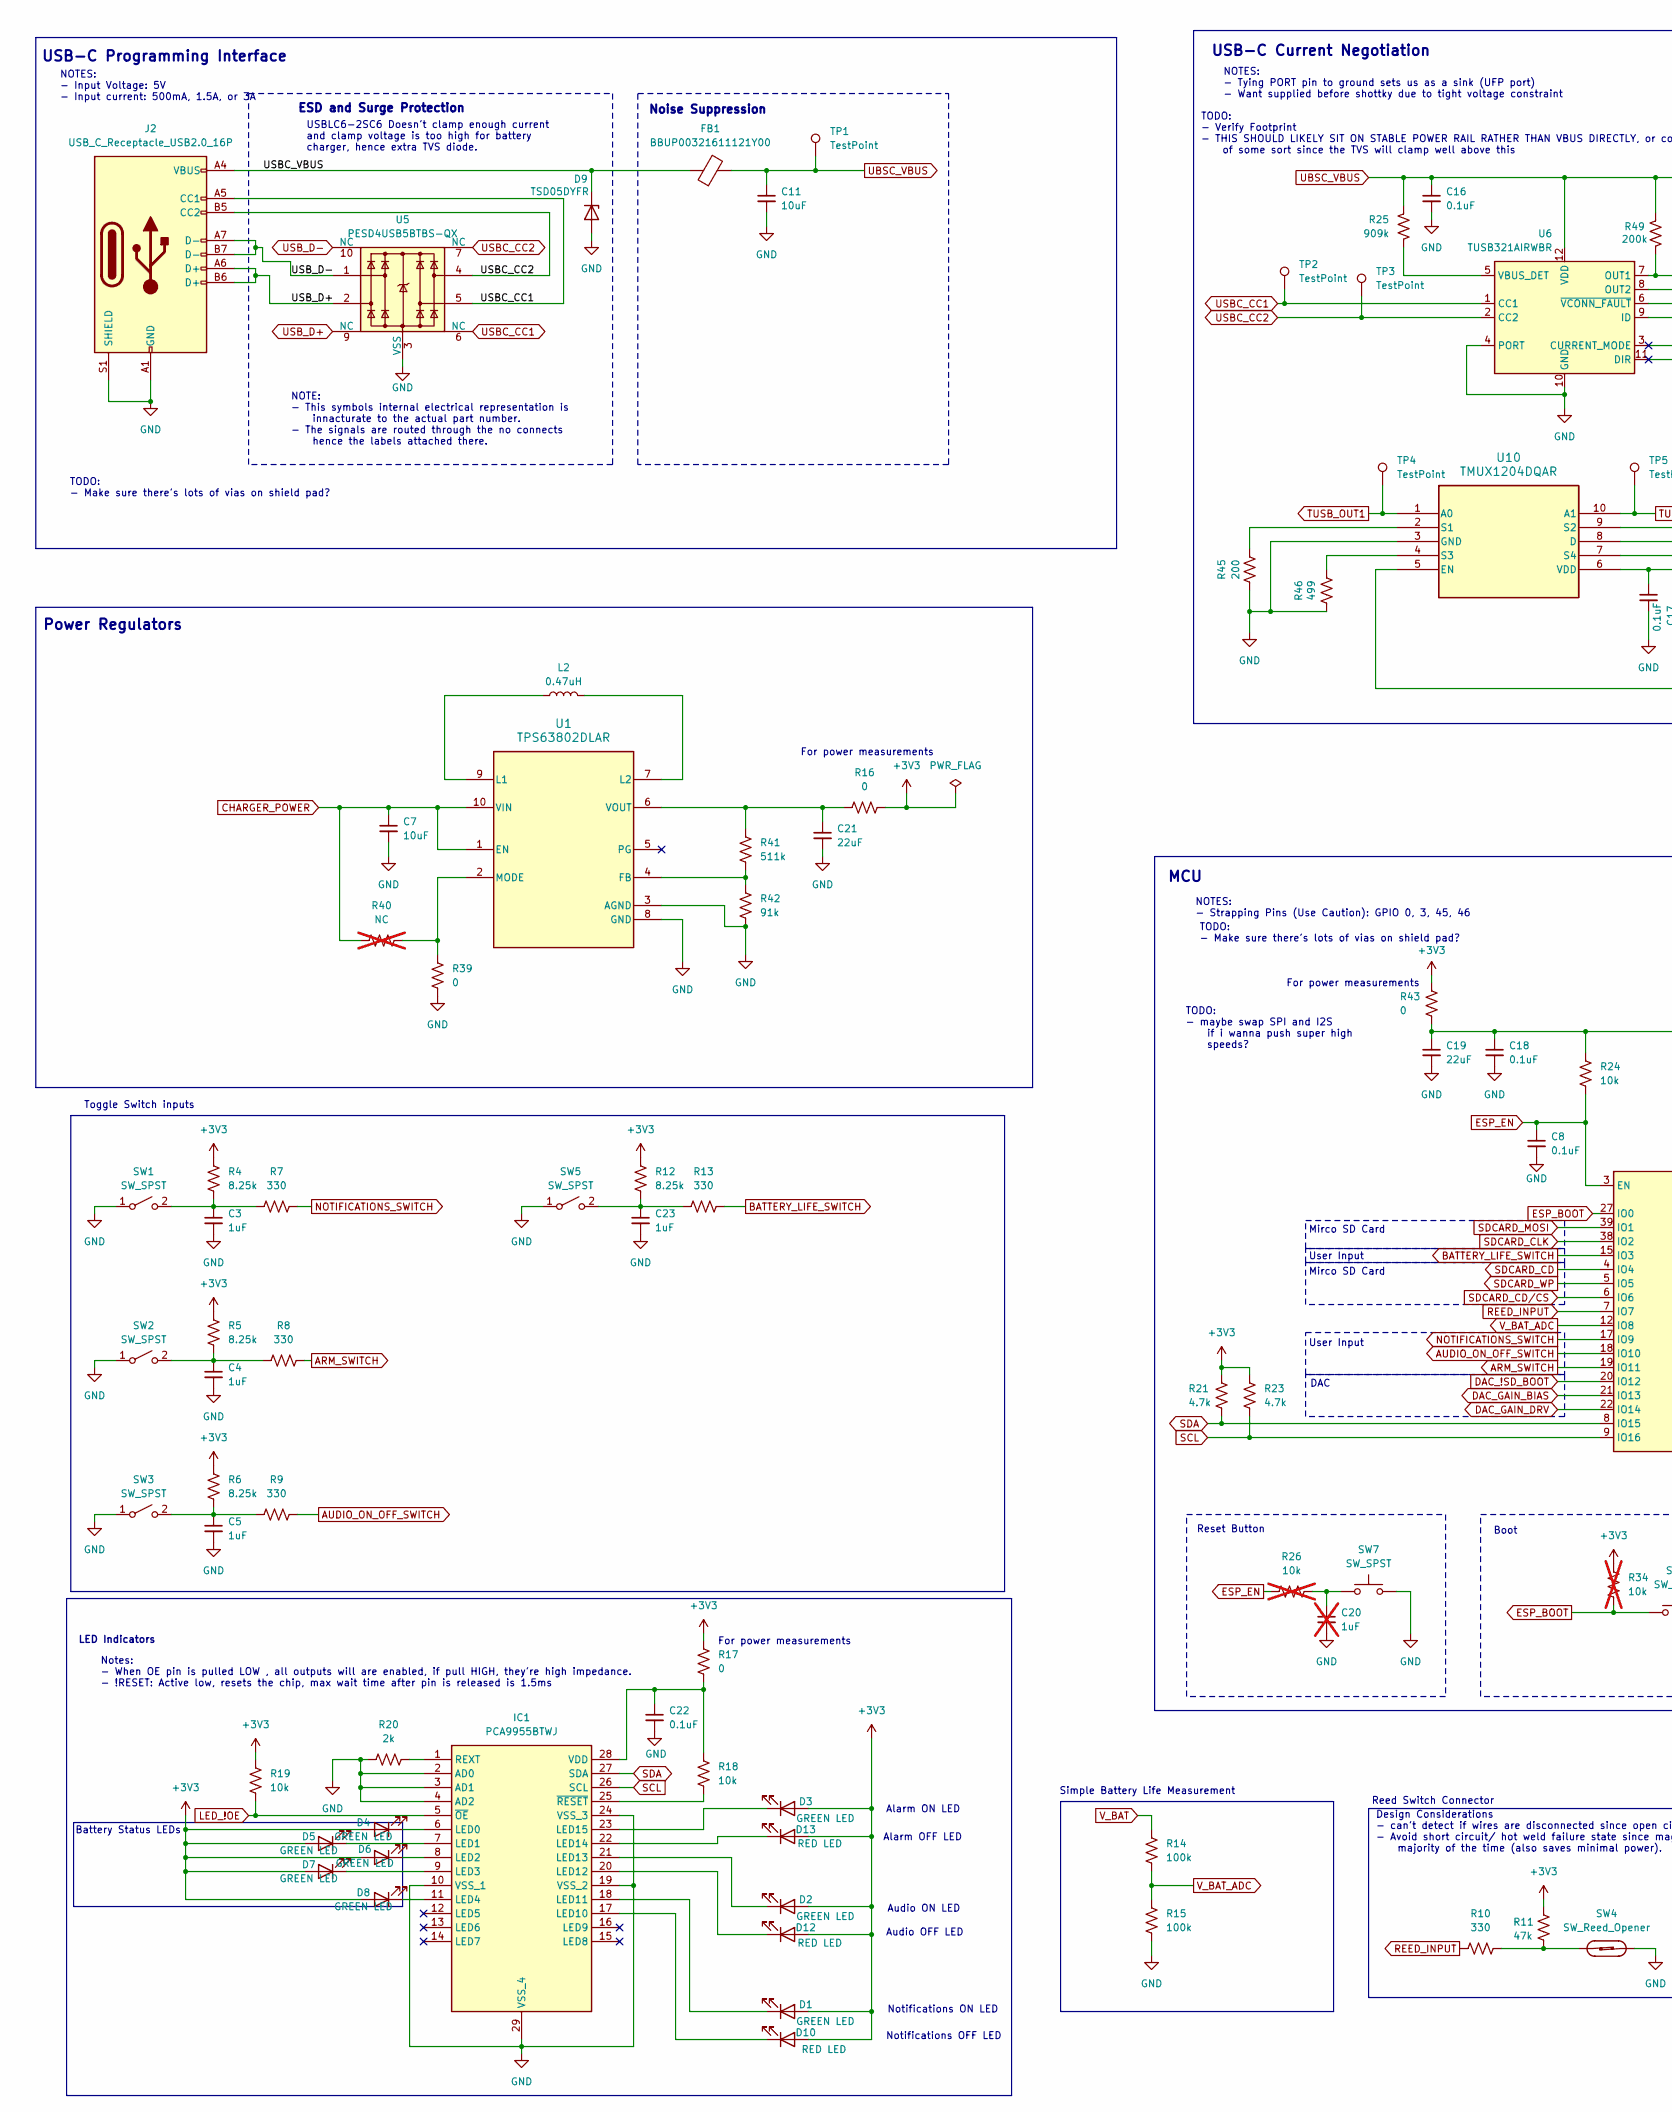
[picture p18: schematic alarm_system_hardware.kicad_sch, part in row 1, column 1]

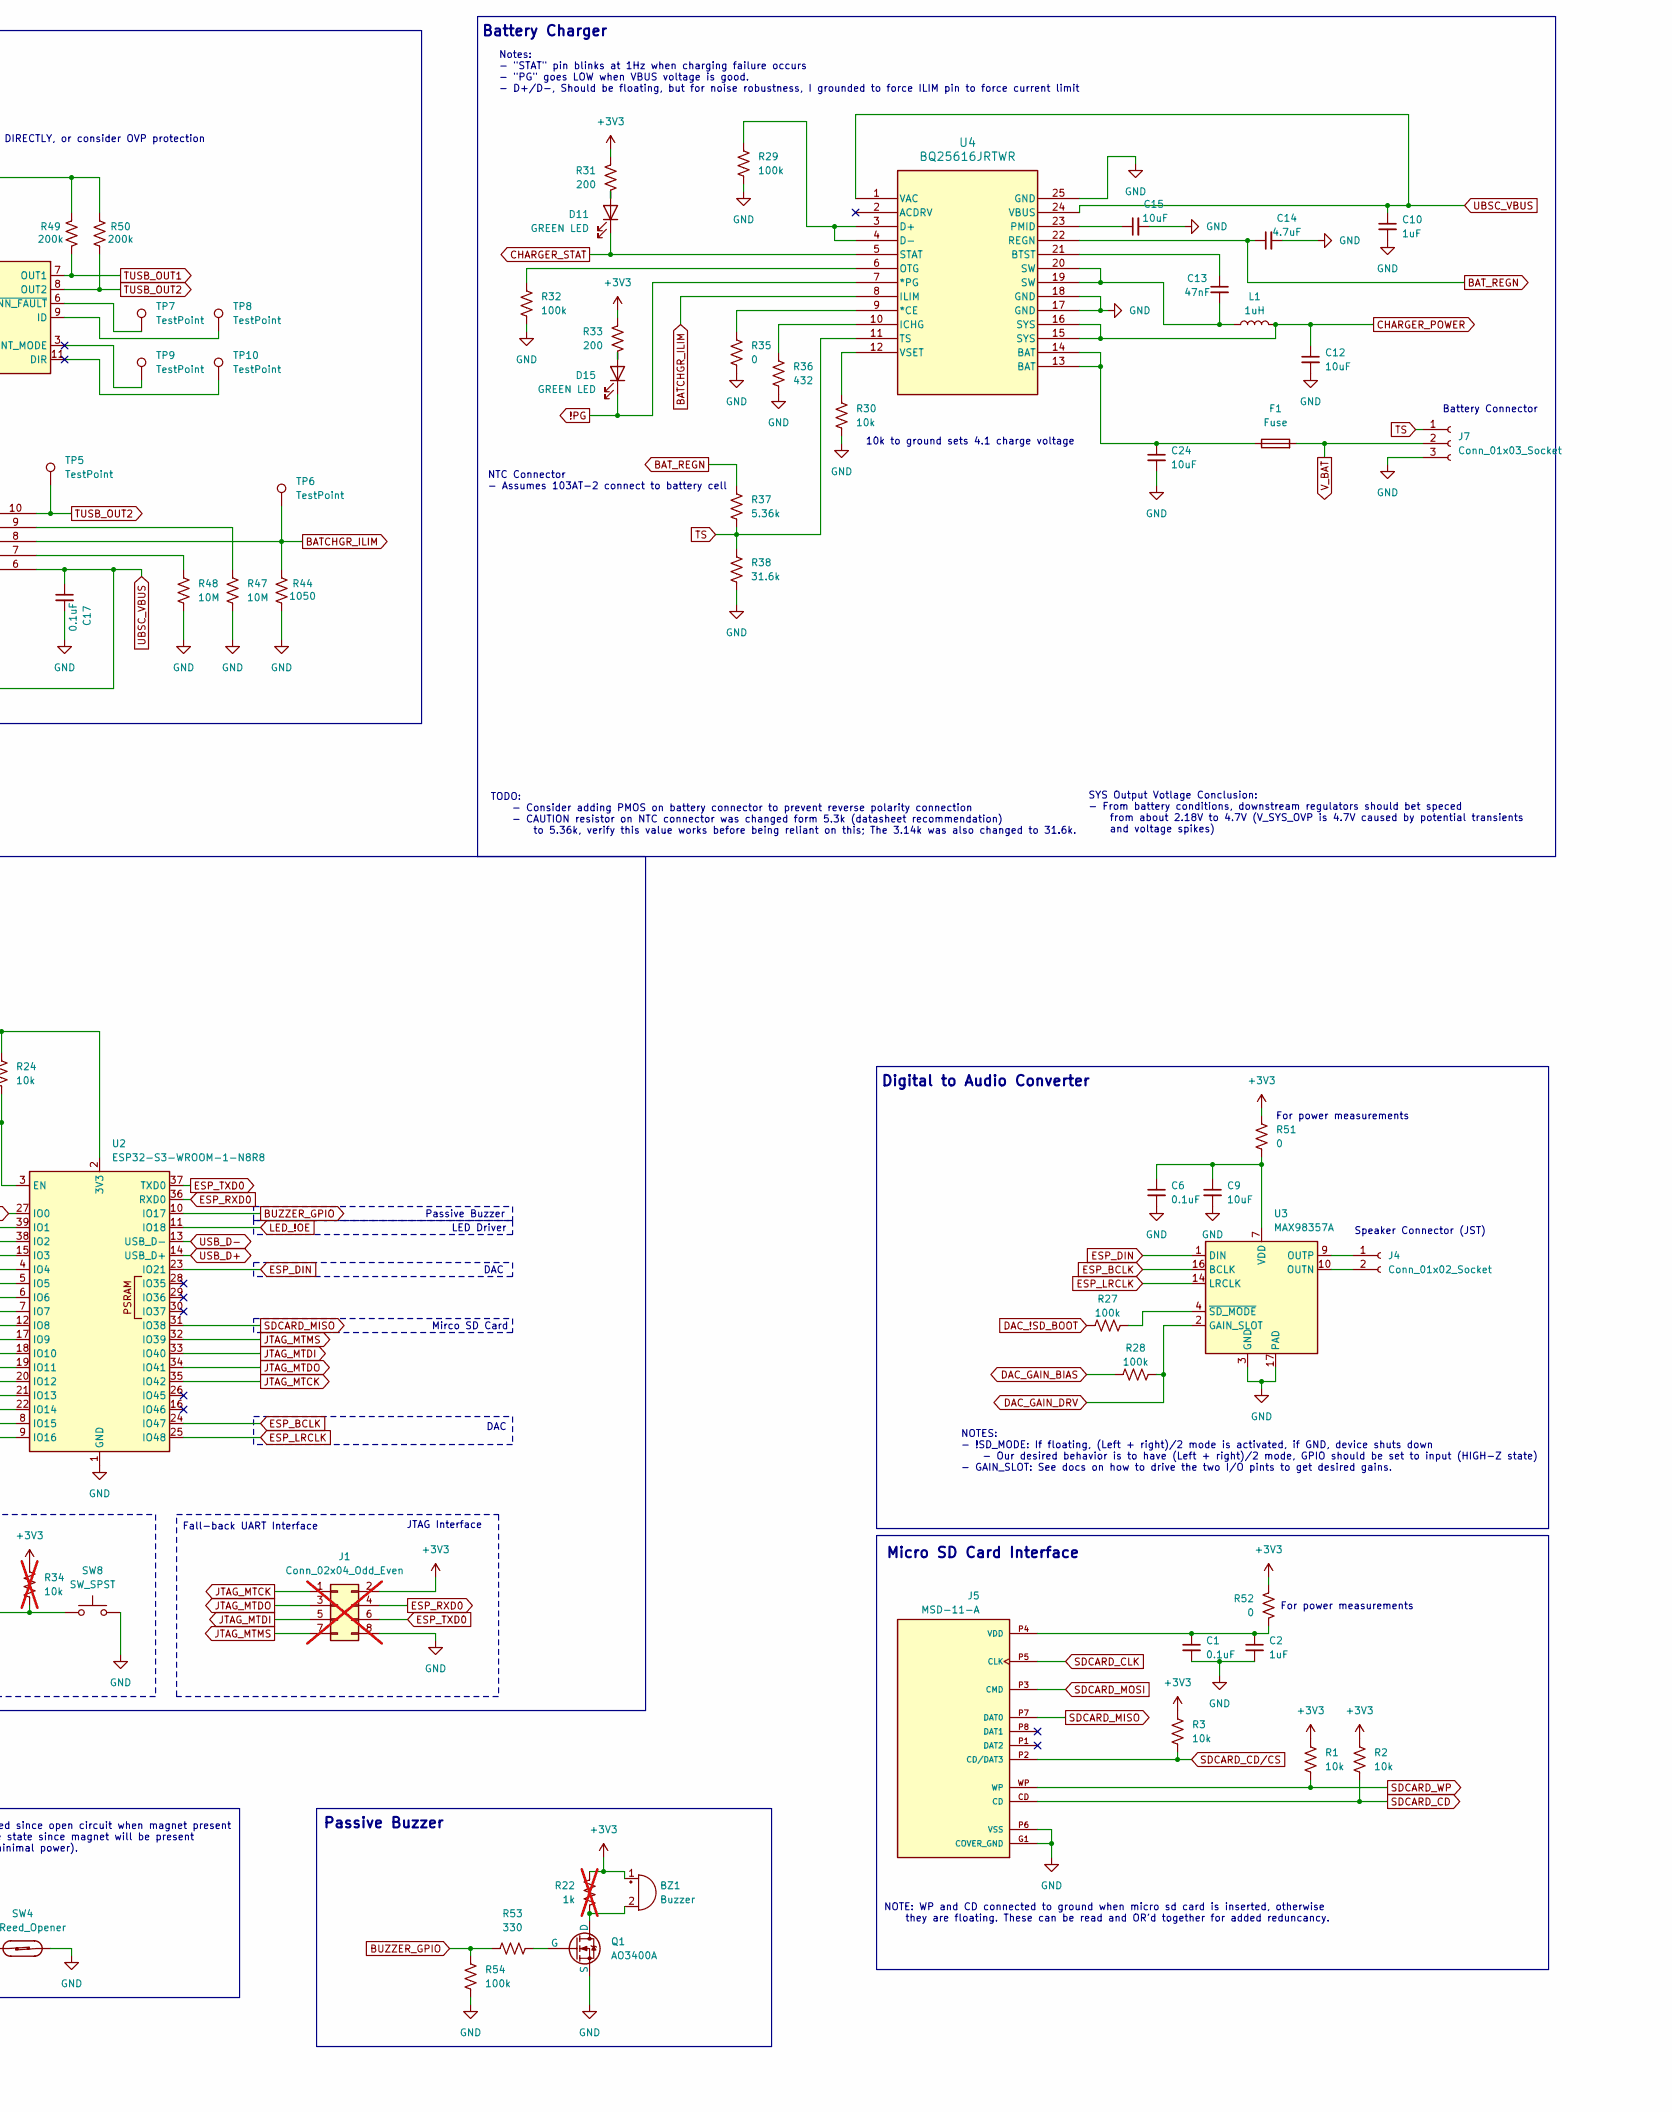
[picture p19: schematic alarm_system_hardware.kicad_sch, part in row 1, column 2]

Parts:
BZ1: Buzzer; PS1440P02BT_TDK; Manufacturer_Part_Number PS1440P02BT
C1, C6, C8, C16, C17, C18, C22: 0.1uF; C_0805_2012Metric_Pad1.18x1.45mm_HandSolder; Manufacturer_Part_Number CC0805KRX7R9BB104
C2, C3, C4, C5, C10, C23: 1uF; C_0805_2012Metric_Pad1.18x1.45mm_HandSolder; Manufacturer_Part_Number GRM21BR71C105KA01L
C7, C9, C11, C12, C15, C24: 10uF; C_0805_2012Metric_Pad1.18x1.45mm_HandSolder; Manufacturer_Part_Number GRM21BR71A106KA73L
C13: 47nF; C_0805_2012Metric_Pad1.18x1.45mm_HandSolder; Manufacturer_Part_Number CL21B473KBCNNNC
C14: 4.7uF; C_0805_2012Metric_Pad1.18x1.45mm_HandSolder; Manufacturer_Part_Number CL21B473KBCNNNC
C19, C21: 22uF; C_0805_2012Metric_Pad1.18x1.45mm_HandSolder; Manufacturer_Part_Number GRM21BZ71A226ME15L
C20: 1uF; C_0805_2012Metric_Pad1.18x1.45mm_HandSolder; Manufacturer_Part_Number GRM21BR71C105KA01L; not fitted
D1, D2, D3, D4, D5, D6, D7, D8, D11, D15: GREEN LED; LED_0805_2012Metric; Manufacturer_Part_Number LTST-C171KGKT
D9: TSD05DYFR; D_SOD-323_HandSoldering; Manufacturer_Part_Number TSD05DYFR
D10, D12, D13: RED LED; LED_0805_2012Metric; Manufacturer_Part_Number LTST-C171KRKT
F1: Fuse; Fuse_0805_2012Metric; Manufacturer_Part_Number MFU0805FF03000P500
FB1: BBUP00321611121Y00; R_1206_3216Metric_Pad1.30x1.75mm_HandSolder; Manufacturer_Part_Number BBUP00321611121Y00
IC1: PCA9955BTWJ; SOP65P640X110-29N; Manufacturer_Part_Number PCA9955BTWJ; Mouser Part Number 771-PCA9955BTW
J1: Conn_02x04_Odd_Even; PinHeader_2x04_P2.54mm_Vertical; not fitted
J2: USB_C_Receptacle_USB2.0_16P; SAMESKY_UJ20-C-H-G-SMT-1-P16-TR; Manufacturer_Part_Number UJ20-C-H-G-SMT-1-P16-TR
J4: Conn_01x02_Socket; CONN_S2B-PH-K-S_JST; Manufacturer_Part_Number S2B-PH-K-S
J5: MSD-11-A; CUI_MSD-11-A; PARTREV 1.02; DigiKey_Part_Number 2223-MSD-11-ACT-ND
J7: Conn_01x03_Socket; TerminalBlock_Phoenix_PT-1,5-3-5.0-H_1x03_P5.00mm_Horizontal; Manufacturer_Part_Number 1935174
L1: 1uH; IND_VLS5045EX-1R0N; Manufacturer_Part_Number VLS5045EX-1R0N
L2: 0.47uH; IND_IHLP-2020CZ-L; Manufacturer_Part_Number IHLP2020CZERR47M11; LCSC Part # C5298158
Q1: AO3400A; SOT-23-3; Manufacturer_Part_Number AO3400A
R1, R2, R3, R18, R19, R24, R30: 10k; R_0805_2012Metric_Pad1.20x1.40mm_HandSolder; Manufacturer_Part_Number RMCF0805FT10K0
R4, R5, R6, R12: 8.25k; R_0805_2012Metric_Pad1.20x1.40mm_HandSolder; Manufacturer_Part_Number RT0805BRD078K25L
R7, R8, R9, R10, R13, R53: 330; R_0805_2012Metric_Pad1.20x1.40mm_HandSolder; Manufacturer_Part_Number RC0805JR-07330RL
R11: 47k; R_0805_2012Metric_Pad1.20x1.40mm_HandSolder; Manufacturer_Part_Number RC0805FR-0747KL
R14, R15, R27, R28, R29, R32, R54: 100k; R_0805_2012Metric_Pad1.20x1.40mm_HandSolder; Manufacturer_Part_Number RC0805FR-07100KL
R16, R17, R35, R39, R43, R51, R52: 0; R_0805_2012Metric_Pad1.20x1.40mm_HandSolder; Manufacturer_Part_Number RC0805JR-070RL
R20: 2k; R_0805_2012Metric_Pad1.20x1.40mm_HandSolder; Manufacturer_Part_Number RC0805FR-072KL
R21, R23: 4.7k; R_0805_2012Metric_Pad1.20x1.40mm_HandSolder; Manufacturer_Part_Number RC0805FR-074K7L
R22: 1k; R_0805_2012Metric_Pad1.20x1.40mm_HandSolder; not fitted
R25: 909k; R_0805_2012Metric_Pad1.20x1.40mm_HandSolder; Manufacturer_Part_Number RC0805FR-07909KL
R26, R34: 10k; R_0805_2012Metric_Pad1.20x1.40mm_HandSolder; Manufacturer_Part_Number RMCF0805FT10K0; not fitted
R31, R33, R45: 200; R_0805_2012Metric_Pad1.20x1.40mm_HandSolder; Manufacturer_Part_Number RC0805FR-07200RL
R36: 432; R_0805_2012Metric_Pad1.20x1.40mm_HandSolder; Manufacturer_Part_Number RC0805FR-07432RL
R37: 5.36k; R_0805_2012Metric_Pad1.20x1.40mm_HandSolder; Manufacturer_Part_Number CRCW08055K36FKEA
R38: 31.6k; R_0805_2012Metric_Pad1.20x1.40mm_HandSolder; Manufacturer_Part_Number RC0805FR-0731K6L
R40: NC; R_0805_2012Metric_Pad1.20x1.40mm_HandSolder; not fitted
R41: 511k; R_0805_2012Metric_Pad1.20x1.40mm_HandSolder; Manufacturer_Part_Number RC0805FR-07511KL
R42: 91k; R_0805_2012Metric_Pad1.20x1.40mm_HandSolder; Manufacturer_Part_Number RC0805FR-0791KL
R44: 1050; R_0805_2012Metric_Pad1.20x1.40mm_HandSolder; Manufacturer_Part_Number RC0805FR-071K05L
R46: 499; R_0805_2012Metric_Pad1.20x1.40mm_HandSolder; Manufacturer_Part_Number RC0805FR-07499RL
R47, R48: 10M; R_0805_2012Metric_Pad1.20x1.40mm_HandSolder; Manufacturer_Part_Number RC0805FR-0710ML
R49, R50: 200k; R_0805_2012Metric_Pad1.20x1.40mm_HandSolder; Manufacturer_Part_Number RC0805FR-07200KL
SW1, SW2, SW3, SW5, SW7, SW8: SW_SPST; SW_SPST_CK_RS282G05A3; Manufacturer_Part_Number PTS636SK25FSMTR LFS
SW4: SW_Reed_Opener; TerminalBlock_Phoenix_PT-1,5-2-5.0-H_1x02_P5.00mm_Horizontal; Manufacturer_Part_Number 1935161
TP1, TP2, TP3, TP4, TP5, TP6, TP7, TP8, TP9, TP10: TestPoint; TestPoint_Pad_D1.0mm
U1: TPS63802DLAR; DLA0010A; Manufacturer_Part_Number TPS63802DLAR
U2: ESP32-S3-WROOM-1-N8R8; ESP32-S3-WROOM-1; Manufacturer_Part_Number ESP32-S3-WROOM-1-N8R8
U3: MAX98357A; TQFN-16-1EP_3x3mm_P0.5mm_EP1.23x1.23mm; Manufacturer_Part_Number MAX98357AETE+T
U4: BQ25616JRTWR; WQFN24_RTW_TEX; Manufacturer_Part_Number BQ25616RTWR
U5: PESD4USB5BTBS-QX; Diodes_UDFN-10_1.0x2.5mm_P0.5mm; Manufacturer_Part_Number PESD4USB5BTBS-QX
U6: TUSB321AIRWBR; Texas_X2QFN-12_1.6x1.6mm_P0.4mm; Manufacturer_Part_Number TUSB321AIRWBR
U10: TMUX1204DQAR; USON10_DQA_TEX; Manufacturer_Part_Number TMUX1204DQAR

Connections:
!PG: D15.1 (K), U4.7 (*PG)
+3V3: BZ1.1 (+), D1.2 (A), D2.2 (A), D3.2 (A), D4.2 (A), D5.2 (A), D6.2 (A), D7.2 (A), D8.2 (A), D10.2 (A), D12.2 (A), D13.2 (A), J1.2, R1.1, R2.1, R3.1, R4.1, R5.1, R6.1, R11.1, R12.1, R16.2, R17.2, R19.1, R21.1, R22.1, R23.1, R31.1, R33.1, R34.1, R43.2, R51.2, R52.2
/USBC_VBUS: D9.1 (K), FB1.1, J2.A4 (VBUS), J2.A9 (VBUS), J2.B4 (VBUS), J2.B9 (VBUS)
ARM_SWITCH: R8.2, U2.19 (IO11)
AUDIO_ON_OFF_SWITCH: R9.2, U2.18 (IO10)
BATCHGR_ILIM: R44.1, TP6.1, U4.8 (ILIM), U10.8 (D)
BATTERY_LIFE_SWITCH: R13.2, U2.15 (IO3)
BAT_REGN: C14.1, R37.1, U4.22 (REGN)
BUZZER_GPIO: R53.2, R54.1, U2.10 (IO17)
CHARGER_POWER: C7.1, C12.1, L1.2, R40.1, U1.1 (EN), U1.10 (VIN), U4.15 (SYS), U4.16 (SYS)
CHARGER_STAT: D11.1 (K), U4.5 (STAT)
DAC_!SD_BOOT: R27.1, U2.20 (IO12)
DAC_GAIN_BIAS: R28.1, U2.21 (IO13)
DAC_GAIN_DRV: R28.2, U2.22 (IO14), U3.2 (GAIN_SLOT)
ESP_BCLK: U2.24 (IO47), U3.16 (BCLK)
ESP_BOOT: R34.2, SW8.1, U2.27 (IO0)
ESP_DIN: U2.23 (IO21), U3.1 (DIN)
ESP_EN: C8.1, R24.2, R26.1, U2.3 (EN)
ESP_LRCLK: U2.25 (IO48), U3.14 (LRCLK)
ESP_RXD0: J1.4, U2.36 (RXD0)
ESP_TXD0: J1.6, U2.37 (TXD0)
GND: C1.2, C2.2, C3.2, C4.2, C5.2, C6.2, C7.2, C8.2, C9.2, C10.2, C11.2, C12.2, C14.2, C15.2, C16.2, C17.2, C18.2, C19.2, C20.2, C21.2, C22.2, C23.2, C24.2, D9.2 (A), IC1.2 (AD0), IC1.3 (AD1), IC1.4 (AD2), IC1.10 (VSS_1), IC1.19 (VSS_2), IC1.24 (VSS_3), IC1.29 (VSS_4), J1.8, J2.A1 (GND), J2.A12 (GND), J2.B1 (GND), J2.B12 (GND), J2.S1 (SHIELD), J5.G1 (COVER_GND), J5.G2 (COVER_GND), J5.P6 (VSS), J7.3, Q1.3 (S), R15.2, R20.1, R29.2, R30.2, R32.2, R35.2, R36.2, R38.2, R39.2, R42.2, R44.2, R45.1, R46.1, R47.2, R48.2, R54.2, SW1.1 (A), SW2.1 (A), SW3.1 (A), SW4.2, SW5.1 (A), SW7.2, SW8.2, U1.3 (AGND), U1.8 (GND), U2.1 (GND), U2.40 (GND), U2.41 (GND), U3.3 (GND), U3.11 (GND), U3.15 (GND), U3.17 (PAD), U4.17 (GND), U4.18 (GND), U4.25 (GND), U5.3 (VSS), U5.8 (VSS), U6.4 (PORT), U6.10 (GND), U10.3 (GND)
JTAG_MTCK: J1.1, U2.35 (IO42)
JTAG_MTDI: J1.5, U2.33 (IO40)
JTAG_MTDO: J1.3, U2.34 (IO41)
JTAG_MTMS: J1.7, U2.32 (IO39)
LED_!OE: IC1.5 (~OE), R19.2, U2.11 (IO18)
NOTIFICATIONS_SWITCH: R7.2, U2.17 (IO9)
unnamed: BZ1.2 (-), Q1.1 (D), R22.2
unnamed: C6.1, C9.1, R51.1, U3.7 (VDD), U3.8 (VDD)
unnamed: C13.2, L1.1, U4.19 (SW), U4.20 (SW)
unnamed: C20.1, R26.2, SW7.1
unnamed: C24.1, F1.1, U4.13 (BAT), U4.14 (BAT)
unnamed: D1.1 (K), IC1.18 (LED11)
unnamed: D2.1 (K), IC1.21 (LED13)
unnamed: D3.1 (K), IC1.23 (LED15)
unnamed: D4.1 (K), IC1.6 (LED0)
unnamed: D5.1 (K), IC1.7 (LED1)
unnamed: D6.1 (K), IC1.8 (LED2)
unnamed: D7.1 (K), IC1.9 (LED3)
unnamed: D8.1 (K), IC1.11 (LED4)
unnamed: D10.1 (K), IC1.17 (LED10)
unnamed: D11.2 (A), R31.2
unnamed: D12.1 (K), IC1.20 (LED12)
unnamed: D13.1 (K), IC1.22 (LED14)
unnamed: D15.2 (A), R33.2
unnamed: IC1.1 (REXT), R20.2
unnamed: C22.1, IC1.28 (VDD), R17.1, R18.1
unnamed: IC1.25 (~RESET), R18.2
unnamed: J4.1, U3.9 (OUTP)
unnamed: J4.2, U3.10 (OUTN)
unnamed: C1.1, C2.1, J5.P4 (VDD), R52.1
unnamed: Q1.2 (G), R53.1
unnamed: R10.2, R11.2, SW4.1
unnamed: C3.1, R4.2, R7.1, SW1.2 (B)
unnamed: C4.1, R5.2, R8.1, SW2.2 (B)
unnamed: C5.1, R6.2, R9.1, SW3.2 (B)
unnamed: C23.1, R12.2, R13.1, SW5.2 (B)
unnamed: R41.2, R42.1, U1.4 (FB)
unnamed: L2.1, U1.9 (L1)
unnamed: L2.2, U1.7 (L2)
unnamed: R39.1, R40.2, U1.2 (MODE)
unnamed: C21.1, R16.1, R41.1, U1.6 (VOUT)
unnamed: C18.1, C19.1, R24.1, R43.1, U2.2 (3V3)
unnamed: R27.2, U3.4 (~SD_MODE)
unnamed: R35.1, U4.9 (*CE)
unnamed: C13.1, U4.21 (BTST)
unnamed: R29.1, U4.3 (D+), U4.4 (D-)
unnamed: R36.1, U4.10 (ICHG)
unnamed: R32.1, U4.6 (OTG)
unnamed: C15.1, U4.23 (PMID)
unnamed: R30.1, U4.12 (VSET)
unnamed: TP8.1, U6.9 (ID)
unnamed: R25.2, U6.5 (VBUS_DET)
unnamed: TP7.1, U6.6 (~VCONN_FAULT)
unnamed: R45.2, U10.2 (S1)
unnamed: R47.1, U10.9 (S2)
unnamed: R46.2, U10.4 (S3)
unnamed: R48.1, U10.7 (S4)
REED_INPUT: R10.1, U2.7 (IO7)
SCL: IC1.26 (SCL), R23.2, U2.9 (IO16)
SDA: IC1.27 (SDA), R21.2, U2.8 (IO15)
SDCARD_CD: J5.CD, R2.2, U2.4 (IO4)
SDCARD_CD/CS: J5.P2 (CD/DAT3), R3.2, U2.6 (IO6)
SDCARD_CLK: J5.P5 (CLK), U2.38 (IO2)
SDCARD_MISO: J5.P7 (DAT0), U2.31 (IO38)
SDCARD_MOSI: J5.P3 (CMD), U2.39 (IO1)
SDCARD_WP: J5.WP, R1.2, U2.5 (IO5)
TS: J7.1, R37.2, R38.1, U4.11 (TS)
TUSB_OUT1: R49.2, TP4.1, U6.7 (OUT1), U10.1 (A0)
TUSB_OUT2: R50.2, TP5.1, U6.8 (OUT2), U10.10 (A1)
UBSC_VBUS: C10.1, C11.1, C16.1, C17.1, FB1.2, R25.1, R49.1, R50.1, TP1.1, U4.1 (VAC), U4.24 (VBUS), U6.12 (VDD), U10.5 (EN), U10.6 (VDD)
USBC_CC1: J2.A5 (CC1), TP2.1, U5.5, U5.6 (NC), U6.1 (CC1)
USBC_CC2: J2.B5 (CC2), TP3.1, U5.4, U5.7 (NC), U6.2 (CC2)
USB_D+: J2.A6 (D+), J2.B6 (D+), U2.14 (USB_D+), U5.2, U5.9 (NC)
USB_D-: J2.A7 (D-), J2.B7 (D-), U2.13 (USB_D-), U5.1, U5.10 (NC)
V_BAT: F1.2, J7.2, R14.1
V_BAT_ADC: R14.2, R15.1, U2.12 (IO8)

Notes on the sheet:
TODO: - maybe swap SPI and I2S if i wanna push super high speeds?
Toggle Switch inputs
For power measurements
10k to ground sets 4.1 charge voltage
Notes: - "STAT" pin blinks at 1Hz when charging failure occurs - "PG" goes LOW when VBUS voltage is good. - D+/D-, Should be floating, but for noise robustness, I grounded to force ILIM pin to force current limit
Notifications ON LED
Design Considerations - can't detect if wires are disconnected since open circuit when magnet present - Avoid short circuit/ hot weld failure state since magnet will be present majority of the time (also saves minimal power).
LED Driver
DAC
NOTES: - Input Voltage: 5V - Input current: 500mA, 1.5A, or 3A
NOTES: - Strapping Pins (Use Caution): GPIO 0, 3, 45, 46
Battery Connector
Mirco SD Card
Micro SD Card Interface
Alarm OFF LED
Noise Suppression
USB-C Programming Interface
Fall-back UART Interface
User Input
Notes: - When OE pin is pulled LOW , all outputs will are enabled, if pull HIGH, they're high impedance. - !RESET: Active low, resets the chip, max wait time after pin is released is 1.5ms
USB-C Current Negotiation
USBLC6-2SC6 Doesn't clamp enough current and clamp voltage is too high for battery charger, hence extra TVS diode.
LED Indicators
NOTES: - !SD_MODE: If floating, (Left + right)/2 mode is activated, if GND, device shuts down - Our desired behavior is to have (Left + right)/2 mode, GPIO should be set to input (HIGH-Z state) - GAIN_SLOT: See docs on how to drive the two I/O pints to get desired gains.
Audio ON LED
NOTES: - Tying PORT pin to ground sets us as a sink (UFP port) - Want supplied before shottky due to tight voltage constraint
JTAG Interface
Boot
MCU
ESD and Surge Protection
Battery Charger
Reset Button
Passive Buzzer
Power Regulators
SYS Output Votlage Conclusion: - From battery conditions, downstream regulators should bet speced from about 2.18V to 4.7V (V_SYS_OVP is 4.7V caused by potential transients and voltage spikes)
Reed Switch Connector
TODO: - Consider adding PMOS on battery connector to prevent reverse polarity connection - CAUTION resistor on NTC connector was changed form 5.3k (datasheet recommendation) to 5.36k, verify this value works before being reliant on this; The 3.14k was also changed to 31.6k.
NOTE: WP and CD connected to ground when micro sd card is inserted, otherwise they are floating. These can be read and OR'd together for added reduncancy.
Simple Battery Life Measurement
NTC Connector - Assumes 103AT-2 connect to battery cell
TODO: - Verify Footprint - THIS SHOULD LIKELY SIT ON STABLE POWER RAIL RATHER THAN VBUS DIRECTLY, or consider OVP protection of some sort since the TVS will clamp well above this
Battery Status LEDs
Alarm ON LED
NOTE: - This symbols internal electrical representation is innacturate to the actual part number. - The signals are routed through the no connects hence the labels attached there.
Notifications OFF LED
TODO: - Make sure there's lots of vias on shield pad?
Digital to Audio Converter
Speaker Connector (JST)
Audio OFF LED

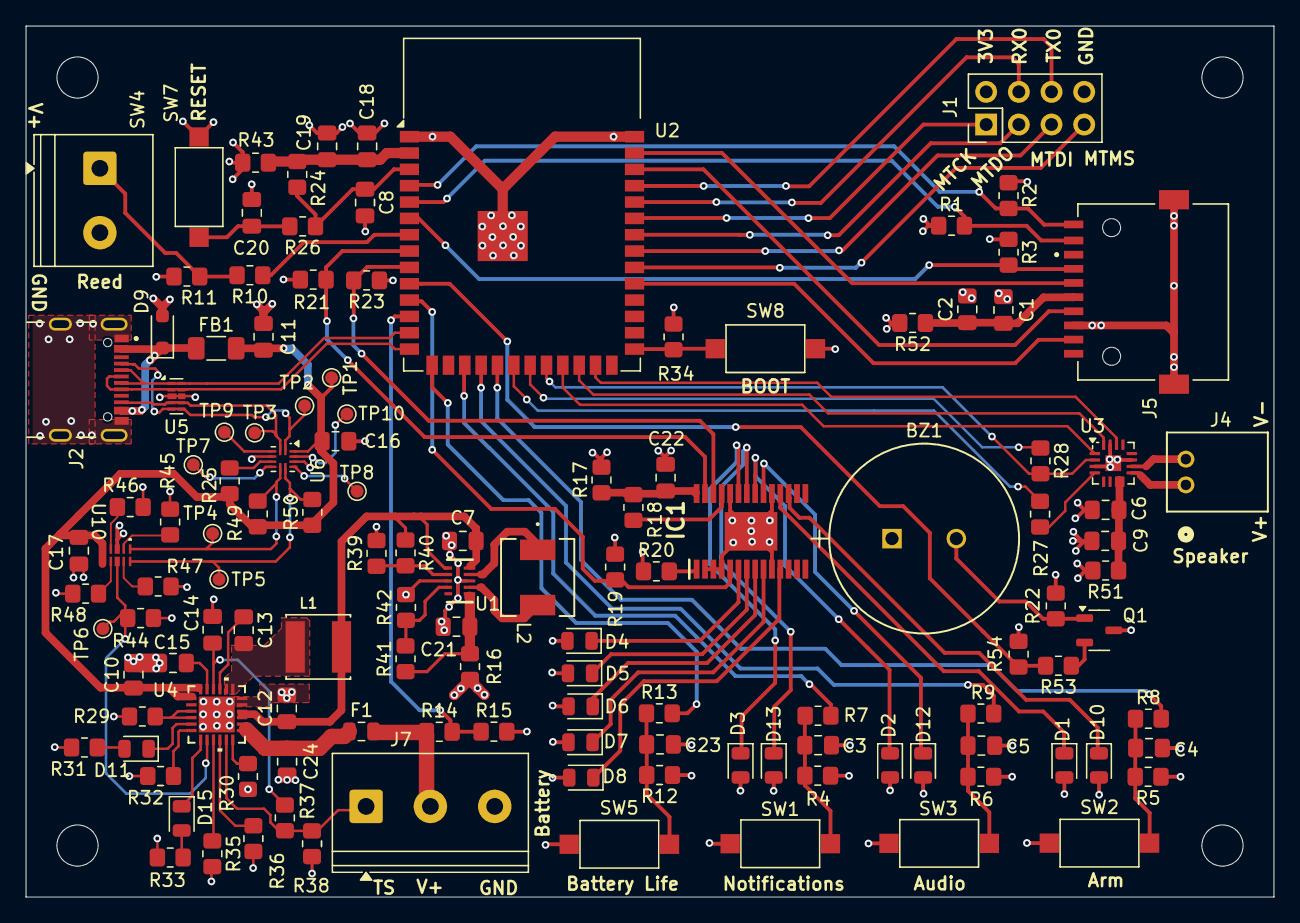
[picture p20: board alarm_system_hardware.kicad_pcb from above]

Board: 4 copper layers, 97.0 x 67.7 mm, 128 parts (0 on the bottom side), 98 nets.
