davidjperez00/alarm-system/src/app/main.c

#include "i2s.h"
#include "spi.h"
#include "audio_amp.h"
#include "micro_sdcard.h"
#include "../drivers/esp32/i2s_device.h"
#include "../drivers/esp32/spi_device.h"
#include "../drivers/esp32/esp32_gpio.h"
#include "../drivers/esp32/sdcard_device.h"
#include "audio_stream/audio_stream.h"
#include "reed_monitor/reed_monitor.h"

// I2S subsystem defines, TODO: eventually should be changed to
// configure i2s channel based on wav file data.
#define SAMPLE_RATE 44100

// for memcmp
#include <string.h>

// esp-idf defines
#include "freertos/FreeRTOS.h"
#include "freertos/task.h"

// wave file from sd card to read
// #define WAV_FILE_NAME "gs-16b-1c-44100hz.wav"
// #define WAV_FILE_NAME "3min-ff-16b-2c-44100hz.wav"

// String concatenation for audio file to play
#define WAV_FILE_NAME   \
    SD_CARD_MOUNT_POINT \
    SD_CARD_MAIN_DIRECTORY "gs-16b-2c-44100hz.wav"

// NOTE: Comment out all of main and run this function at the end of main.
void test_amp(void)
{

    // Register ESP32 I2S driver with subsystem wrapper
    i2s_driver_register_esp32();
    // Register ESP32 SPI driver with subsystem wrapper
    // driver_esp32_spi_register_ops();
    // Register ESP32 gpio driver with subsystem wrapper
    esp32_gpio_driver_register_ops();

    i2s_init(SAMPLE_RATE, 16, 2);

    // initalize the amp
    audio_amp_init();

    // Delay for some time in case there is a brownout??
    vTaskDelay(pdMS_TO_TICKS(1000)); // Delay for 1 second

    printf("TESTING: going to start sending wav \r\n");

    // TESTING FOR POWER REAL QUICK
    send_sin_wav_part1();

    // BELOW IS TEST CODE IF MULTIPLE GAINS ARE SUPPORTED
    // audio_amp_gain test_gain = AUDIO_AMP_GAIN_3DB;
    // while (1)
    // {
    //     printf("Testing gain: %d dB\r\n", 3 + ((int)test_gain * 3));

    //     if (!audio_amp_set_gain(test_gain))
    //     {
    //         printf("ERROR: failed to set amplifier gain\r\n");
    //     }
    //     else
    //     {
    //         send_sin_wav_part1();
    //     }

    //     vTaskDelay(pdMS_TO_TICKS(1500));

    //     test_gain = (audio_amp_gain)(test_gain + 1);

    //     if (test_gain >= AUDIO_AMP_GAIN_MAX)
    //     {
    //         test_gain = AUDIO_AMP_GAIN_3DB;
    //     }
    // }
    // Used to prevent popping when audio file finishes playing
    i2s_deinit();
}

void app_main(void)
{
    /* BSP WRAPPER INITIALIZATIONS */
    // Register ESP32 I2S driver with subsystem wrapper
    i2s_driver_register_esp32();
    // Register ESP32 SPI driver with subsystem wrapper
    driver_esp32_spi_register_ops();
    // Register ESP32 gpio driver with subsystem wrapper
    esp32_gpio_driver_register_ops();

    /* BSP INTERNAL PERIPHERAL INITIALIZATIONS */
    // Init I2S with basic configuration
    // TODO: This should probably be set for the specific wav file that is going to be played.
    i2s_init(SAMPLE_RATE, 16, 2);
    // Init SPI with basic configuration
    spi_init();

    /* BSP EXTERNAL PERIPHERAL INITIALIZATIONS */
    // initalize the amp
    audio_amp_init();
    // Initialize the sd card (this includes mounting the file system)
    micro_sdcard_init();

    /* MAIN PROGRAM RUN */
    audio_stream_wav_file(WAV_FILE_NAME);

    // Used to prevent popping when audio file finishes playing
    i2s_deinit();

    /*
    // old main working code above
    // TODO: WIP audio amp test code:
    */

    // test_amp();
}

// OLDER REED MONITOR TESTING CODE:
// if (!reed_monitor_init())
// {
//     printf("MAIN FAILED\r\n");
//     return;
// }

// while (1)
// {
//     // Note return value intentionally ignored:
//     reed_monitor_debounce_pin();
//     vTaskDelay(pdMS_TO_TICKS(10));
// }
