davidjperez00/alarm-system/src/drivers/esp32/sdcard_device.c

#include "sdcard_device.h"

// esp-idf libraries
#include "driver/sdspi_host.h"
#include "esp_vfs_fat.h"
#include "sdmmc_cmd.h"

static sdmmc_card_t *card;

void driver_esp32_sdcard_init(uint8_t gpio_num)
{
  sdmmc_host_t host = SDSPI_HOST_DEFAULT();
  host.max_freq_khz = 10000;

  sdspi_device_config_t slot_config = SDSPI_DEVICE_CONFIG_DEFAULT();
  slot_config.gpio_cs = gpio_num;
  slot_config.host_id = SPI2_HOST;

  esp_vfs_fat_sdmmc_mount_config_t mount_config = {
      .format_if_mount_failed = false,
      .max_files = 10,
  };

  ESP_ERROR_CHECK(esp_vfs_fat_sdspi_mount(SD_CARD_MOUNT_POINT, &host, &slot_config, &mount_config, &card));
}
