davidjperez00/alarm-system/(commit log)

2025-12-19 Initial i2s testing with esp32 and esp idf
2025-12-23 play 440hz for 1 second
2026-01-10 wip driver testing
2026-03-20 wip initial prototype, need final schematic review
    [DQA0010A.stp, PCA9955BTW.stp, RTW0024H.stp, alarm_system_hardware.kicad_pcb, alarm_system_hardware.kicad_sch, hardware_bom.xlsx]
2026-05-15 Add footprints for remaining parts
    [DLA0010A.stp, IHLP2020CZ.step, MSD-11-A.step, UJ20-C-H-G-SMT-1-P16-TR.step, VLS5045EX-1R0N.step, alarm_system_hardware.csv, alarm_system_hardware.kicad_sch, hardware_bom.xlsx]
2026-08-01 Completed V0.01 PCB and production files
    [BQ25616JRTWR.step, KS-01Q-01.STEP, LTST-C235KGKRKT.STEP, MAX98357AETE+T.STEP, NCE2.stp, PS1440P02BT_TDK.step, S2B-PH-K-S.STEP, TMUX1204DQAR.STEP]
2026-08-06 Creating amp subsytem and adjusting spi IO pins
2026-10-01 PCBA export file and related hardware changes
    [BOM.csv, BOM_2.csv, BOM_3.csv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]
